WiseLord/ampcontrol/files/sch/ks0066.png

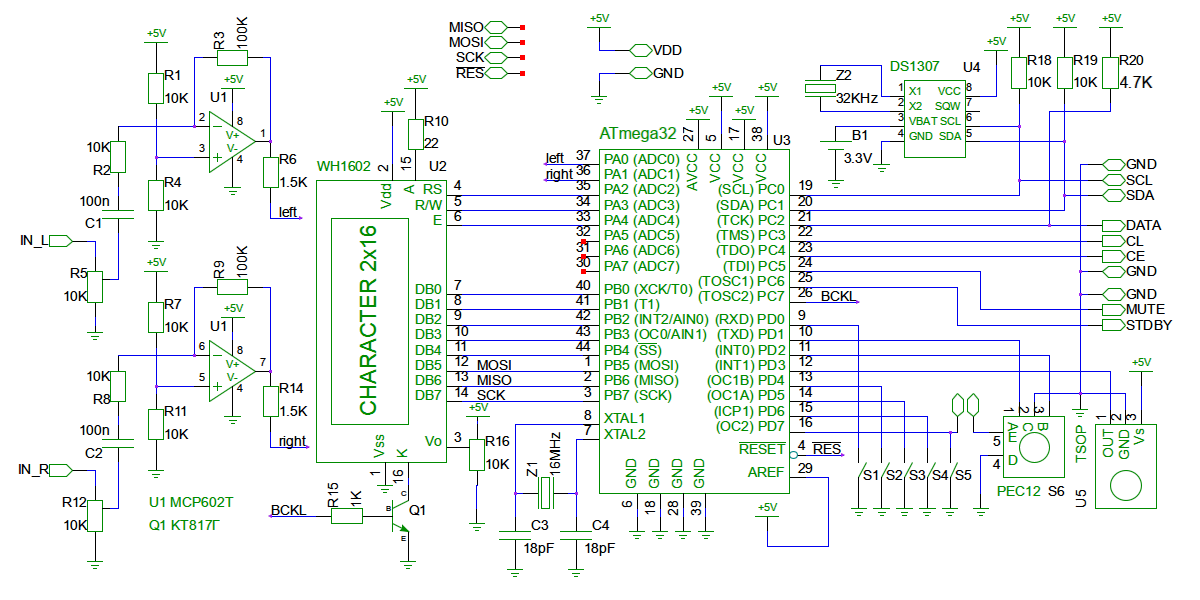
files/sch/ks0066.png
