WiseLord/ampcontrol/files/sch/ks0108a.png

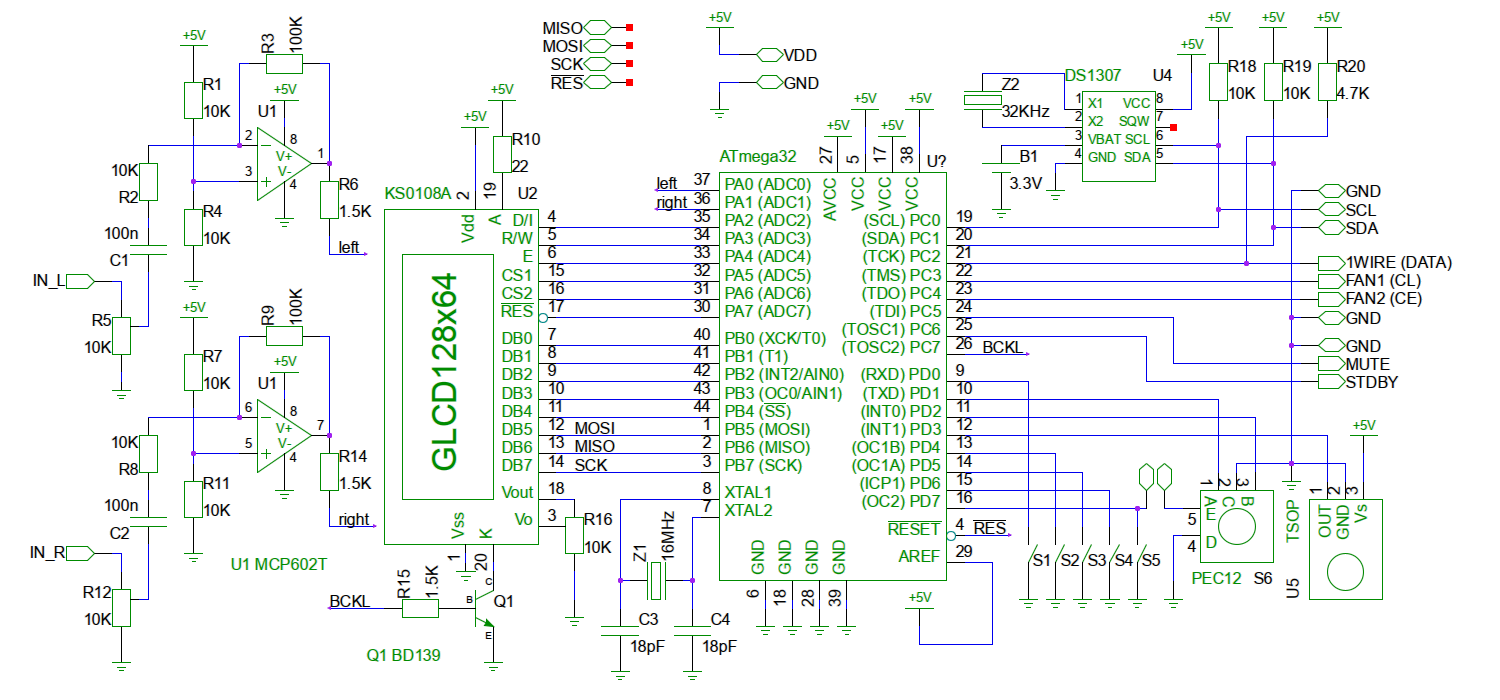
files/sch/ks0108a.png
