WiseLord/ampcontrol/files/sch/ls020.png

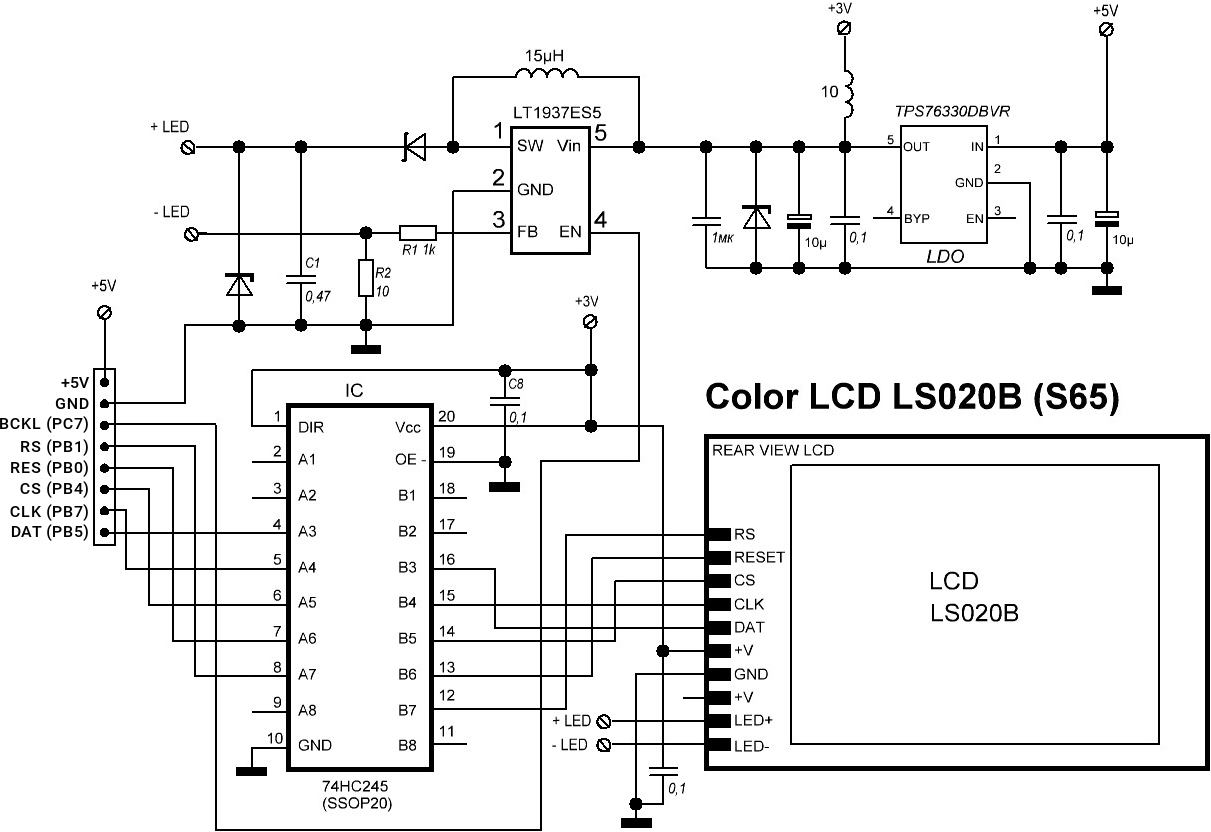
files/sch/ls020.png
