WiseLord/ampcontrol/files/sch/m328-ks0108a.png

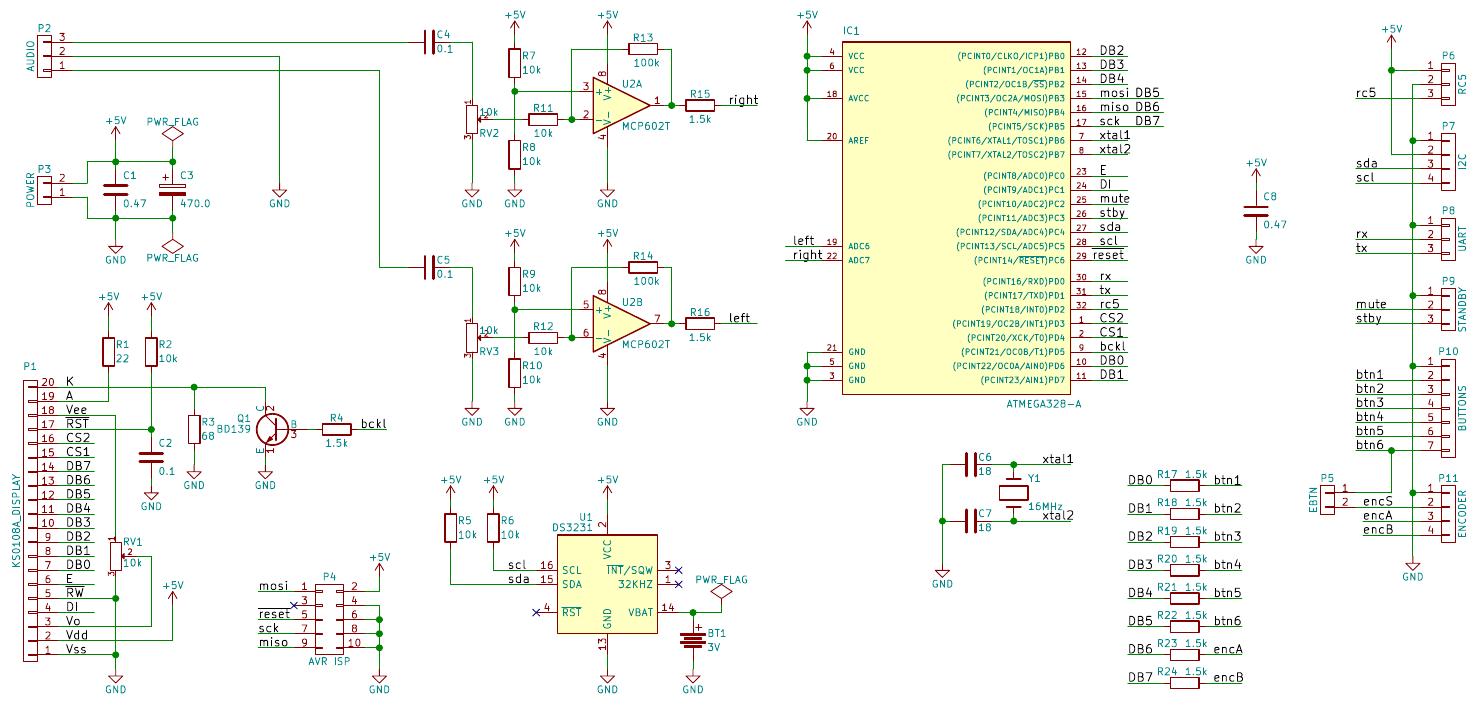
files/sch/m328-ks0108a.png
