WiseLord/ampcontrol/(threads)

Thread 2 (2016-12-08):

Настройки в виде меню

pirat777knj, 2016-12-08:
Хотелось бы видеть более расширенные настройки.
Предлагаю для настроек всего и вся использовать отдельную кнопку "меню",
и внутри менюшку. Структура вложена в файле.
[Структура меню.pdf](https://github.com/WiseLord/ampcontrol/files/640068/default.pdf)

Ну и естественно оставить кнопку быстрых настроек аудио.

pirat777knj, 2016-12-08:
Извиняюсь. Писал с телефона. Не знаю что с форматирование. Дома попробую поправить

WiseLord, 2016-12-08:
Непонятна структура такого меню, как оно должно выглядеть, и как им управлять.

pirat777knj, 2016-12-08:
Сделал в файле. Должно быть понятно.
Также есть еще одно пожелание.
При регулировке громкости сделайте, пожалуйста, отображение единицами в плюс.
А то регулировка сбивает с толку. Домочадцы уже весь мозг проели вопросом: почему так?
А вот в предусилителе, думаю, будет толково оставить регулировку в минус.

pirat777knj, 2016-12-08:
Спешу сообщить - оформил, чтобы было понятно.
Вы просто молодец. Хорошая у Вас родилась мысль и Вы её развиваете.

2016-12-08 14:06 GMT+03:00 WiseLord <notifications@github.com>:

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

WiseLord, 2016-12-08:
Такая структура меню и настроек звука (отдельный набор тембров и т.д. для каждого входа) полностью несовместима с текущим кодом. Возможно. в другом проекте что-то подобное и будет.

Показания при регулировках полностью соответстауют даташитам на аудиопроцессоры и здравому смыслу. Менять их на "попугаи" от нуля до N нет никакого смысла.

По поводу регулировки контраста хотелось бы узнать, как это физически должно происходить.

Ну и хотелось бы увидеть, как в подобном меню должно реализовываться управление кнопками.

pirat777knj, 2016-12-08:
Эм... То есть как физически должена происходить регулировка контраста? Он
же сделана. У меня через пять минут контраст падает. И обратно
восстанавливается только когда выключишь. Или начнешь яркость регулировать.
В остальных случаях он не возвращается обратно.
Неужели это где то косяк? 0_о

Навигация..... Нажатие на энкодер - вход, скажем 3я кнопка - назад,
вращение энкодера - пролистывание. Как на 3д принтерах сделано. Там один
энкодер. А меню огроменное!

А в каком другом проекте вы будете это реализовывать?

8 дек. 2016 г. 20:36 пользователь "WiseLord" <notifications@github.com>
написал:

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

WiseLord, 2016-12-08:
Контраст постоянен и задаётся только подстроечными резисторами. Если он меняется во время работы - ничего кроме плавающего напряжения питания на ум не приходит.

pirat777knj, 2016-12-08:
С этим буду разбираться. До мя доперло, что что-то не так.

8 дек. 2016 г. 20:54 пользователь "WiseLord" <notifications@github.com>
написал:

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

pirat777knj, 2016-12-12:
Добрый день. Вижу вас совсем не интересует предложенный мной функционал.
Несмотря на то, что промышленные ресиверы им обладают.
Как вы уже догадались - то я купил вашу плату в виде конструктора.
Не буду капать на мозги обратной связью с разработчиком и прочим. На этом
форуме все равно никогда не прислушиваются и почему-то считают всё бредом.
Сделаем проще. Вас устроит цена в 500 рублей за пару строк кода?

8 дек. 2016 г. 20:58 пользователь "Ратибор Конжин" <pirat777knj@gmail.com>
написал:

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

Arik333, 2016-12-13:
Прошу добавить поддержку синтезатора LC72131.

Closed 2020-04-08.

Thread 4 (2017-06-29):

Ошибка при компиляции, в чём причина подскажите

freecheng01, 2017-06-29:
C:\ampcontrol-m32-20170109\fft.c:38: ошибка: 'sinTable' is static but used in inline function 'sinTbl' which is not static [-Werror]
  ret = pgm_read_byte(&sinTable[phi & 0x1F]);
                       ^

WiseLord, 2017-06-29:
Причина указана в сообщении об ошибке. Берите или компилятор подревнее (<5.0) или исходники поновее, где это уже поправлено https://github.com/WiseLord/ampcontrol/commit/c34a5e0815c25a95a042597a09573819a85a126e

freecheng01, 2017-06-29:
Спасибо, немного уже разобрался , взял 5c041ba всё проходит. Ещё вопрос - для корпуса dip40 изменений в программе не требуется? Разводку печатки переделаю под себя.

WiseLord, 2017-06-29:
Нет, главное, чтобы функционально те же ножки (пусть и с другой нумерацией) были использованы на тех же местах. Кстати, на форуме радиокота, где-то на первых страницах ветки, плата под DIP40 корпус выкладывалась.

freecheng01, 2017-06-29:
Здорово, сейчас поищу. Ещё раз спасибо за проект, сам я пытался на 328 сделать но не осилил, знаний маловато и опыта, а Ваш проект зацепил, особенно в плане прорисовки экрана из ОЗУ. Буду его использовать как обучалку.

WiseLord, 2017-06-29:
Собственно, ветка кода под m328 в проекте тоже имеется.

Closed 2017-06-29.

Thread 5 (2019-10-24):

перестало компилиться

garik816, 2019-10-24:
перестало компилиться после вчерашнего обновления (Align with m8 code)

ampcontrol-m16# make -j4 MCU=atmega16 APROC_LIST=TDA7439 TUNER_LIST=NOTUNER DISPLAY=KS0066_16X2_8BIT
avr-gcc -Wall -Werror -lm -Os -mcall-prologues -fshort-enums -ffunction-sections -fdata-sections -ffreestanding -flto -mmcu=atmega16 -DF_CPU=16000000L -MMD -MP -MT build/main.o -MF build/./main.d -D_atmega16 -D_KS0066_16X2_8BIT -D_TDA7439 -D_NOTUNER -D_RDA5807_DF -c -o build/main.o main.c
avr-gcc -Wall -Werror -lm -Os -mcall-prologues -fshort-enums -ffunction-sections -fdata-sections -ffreestanding -flto -mmcu=atmega16 -DF_CPU=16000000L -MMD -MP -MT build/input.o -MF build/./input.d -D_atmega16 -D_KS0066_16X2_8BIT -D_TDA7439 -D_NOTUNER -D_RDA5807_DF -c -o build/input.o input.c
avr-gcc -Wall -Werror -lm -Os -mcall-prologues -fshort-enums -ffunction-sections -fdata-sections -ffreestanding -flto -mmcu=atmega16 -DF_CPU=16000000L -MMD -MP -MT build/actions.o -MF build/./actions.d -D_atmega16 -D_KS0066_16X2_8BIT -D_TDA7439 -D_NOTUNER -D_RDA5807_DF -c -o build/actions.o actions.c
avr-gcc -Wall -Werror -lm -Os -mcall-prologues -fshort-enums -ffunction-sections -fdata-sections -ffreestanding -flto -mmcu=atmega16 -DF_CPU=16000000L -MMD -MP -MT build/i2c.o -MF build/./i2c.d -D_atmega16 -D_KS0066_16X2_8BIT -D_TDA7439 -D_NOTUNER -D_RDA5807_DF -c -o build/i2c.o i2c.c
avr-gcc -Wall -Werror -lm -Os -mcall-prologues -fshort-enums -ffunction-sections -fdata-sections -ffreestanding -flto -mmcu=atmega16 -DF_CPU=16000000L -MMD -MP -MT build/rtc.o -MF build/./rtc.d -D_atmega16 -D_KS0066_16X2_8BIT -D_TDA7439 -D_NOTUNER -D_RDA5807_DF -c -o build/rtc.o rtc.c
avr-gcc -Wall -Werror -lm -Os -mcall-prologues -fshort-enums -ffunction-sections -fdata-sections -ffreestanding -flto -mmcu=atmega16 -DF_CPU=16000000L -MMD -MP -MT build/remote.o -MF build/./remote.d -D_atmega16 -D_KS0066_16X2_8BIT -D_TDA7439 -D_NOTUNER -D_RDA5807_DF -c -o build/remote.o remote.c
avr-gcc -Wall -Werror -lm -Os -mcall-prologues -fshort-enums -ffunction-sections -fdata-sections -ffreestanding -flto -mmcu=atmega16 -DF_CPU=16000000L -MMD -MP -MT build/fft.o -MF build/./fft.d -D_atmega16 -D_KS0066_16X2_8BIT -D_TDA7439 -D_NOTUNER -D_RDA5807_DF -c -o build/fft.o fft.c
avr-gcc -Wall -Werror -lm -Os -mcall-prologues -fshort-enums -ffunction-sections -fdata-sections -ffreestanding -flto -mmcu=atmega16 -DF_CPU=16000000L -MMD -MP -MT build/adc.o -MF build/./adc.d -D_atmega16 -D_KS0066_16X2_8BIT -D_TDA7439 -D_NOTUNER -D_RDA5807_DF -c -o build/adc.o adc.c
avr-gcc -Wall -Werror -lm -Os -mcall-prologues -fshort-enums -ffunction-sections -fdata-sections -ffreestanding -flto -mmcu=atmega16 -DF_CPU=16000000L -MMD -MP -MT build/ks0066.o -MF build/display/ks0066.d -D_atmega16 -D_KS0066_16X2_8BIT -D_TDA7439 -D_NOTUNER -D_RDA5807_DF -c -o build/display/ks0066.o display/ks0066.c
avr-gcc -Wall -Werror -lm -Os -mcall-prologues -fshort-enums -ffunction-sections -fdata-sections -ffreestanding -flto -mmcu=atmega16 -DF_CPU=16000000L -MMD -MP -MT build/display.o -MF build/./display.d -D_atmega16 -D_KS0066_16X2_8BIT -D_TDA7439 -D_NOTUNER -D_RDA5807_DF -c -o build/display.o display.c
avr-gcc -Wall -Werror -lm -Os -mcall-prologues -fshort-enums -ffunction-sections -fdata-sections -ffreestanding -flto -mmcu=atmega16 -DF_CPU=16000000L -MMD -MP -MT build/audio.o -MF build/audio/audio.d -D_atmega16 -D_KS0066_16X2_8BIT -D_TDA7439 -D_NOTUNER -D_RDA5807_DF -c -o build/audio/audio.o audio/audio.c
display.c:701:7: error: expected identifier or ‘(’ before ‘else’
     } else {
       ^
display.c:704:1: error: expected identifier or ‘(’ before ‘}’ token
 }
 ^
make: *** [Makefile:152: build/display.o] Ошибка 1
make: *** Ожидание завершения заданий…

Closed 2019-10-27.
