WiseLord/ampcontrol/(list of files, drawings)

Other design files:
files/pcbs-m32.lay6
files/sim-m32-proteus7-ls020.dsn
files/sim-m32-proteus7.dsn
files/sim-m328-proteus7.dsn
