WiseLord/ampcontrol/remote/defines.h

#ifndef DEFINES_H
#define DEFINES_H

#define ORGANIZATION_NAME           "WiseLord"
#define ORGANIZATION_DOMAIN         "github.io"
#define APPLICATION_NAME            "Ampcontrol"

#define SETTINGS_SERIAL             "SerialPort"
#define SETTINGS_SERIAL_PORTNAME    "SerialPort/PortName"
#define SETTINGS_SERIAL_BAUDRATE    "SerialPort/BaudRate"
#define SETTINGS_SERIAL_DATABITS    "SerialPort/DataBits"
#define SETTINGS_SERIAL_PARITY      "SerialPort/Parity"
#define SETTINGS_SERIAL_STOPBITS    "SerialPort/StopBits"
#define SETTINGS_SERIAL_FLOWCTRL    "SerialPort/FlowCtrl"

#define SETTINGS_BT                 "Bluetooth"
#define SETTINGS_BT_DEVICE          "Bluetooth/Device"

#define SETTINGS_APP                "Application"
#define SETTINGS_APP_AUTOCONNECT    "Application/Autoconnect"
#define SETTINGS_APP_AUTOCONNTIME   "Application/AutoconnectTimeout"
#define SETTINGS_APP_HIDEONSTART    "Application/HideOnStartup"

#endif // DEFINES_H
