WiseLord/ampcontrol/remote/main.cpp

#include "mainwindow.h"
#include "defines.h"

#include <QApplication>
#include <QTranslator>

int main(int argc, char *argv[])
{
    QCoreApplication::setOrganizationName(ORGANIZATION_NAME);
    QCoreApplication::setOrganizationDomain(ORGANIZATION_DOMAIN);
    QCoreApplication::setApplicationName(APPLICATION_NAME);

    QApplication a(argc, argv);

    QTranslator translator;
    translator.load(":/ts/ts/remote_" + QLocale::system().bcp47Name().remove(QRegExp("-.*")));
    a.installTranslator(&translator);

    MainWindow w;

    return a.exec();
}
