WiseLord/ampcontrol/src/display.c

#include "display.h"

#include <avr/pgmspace.h>
#include <avr/eeprom.h>

#ifdef _ALARM
#include "alarm.h"
#endif
#include "adc.h"
#include "eeprom.h"
#include "input.h"
#include "remote.h"
#include "rtc.h"
#include "tuner/tuner.h"
#ifdef _RDS
#include "tuner/rds.h"
#endif
#ifdef _TEMPCONTROL
#include "temp.h"
#endif

static int8_t brStby;                       // Brightness in standby mode
static int8_t brWork;                       // Brightness in working mode

static SpMode spMode;                       // Spectrum mode
static FallSpeed fallSpeed;                 // Spectrum fall speed

static uint8_t rcIndex = CMD_RC_STBY;

static uint8_t defDisplay;                  // Default display mode

char strbuf[STR_BUFSIZE + 1];               // String buffer
uint8_t *txtLabels[LABEL_END];              // Array with text label pointers

#if defined(_KS0066)
static LcdSymGroup userSybmols = LCD_END;   // Generated user symbols for ks0066
static LcdUserAddSym userAddSym = SYM_END;  // Additional user symbol
#endif

// Names of RC functions, MUST correspond to CmdID enum
const char STR_RC_STBY[]        PROGMEM = "Standby mode";
const char STR_RC_MUTE[]        PROGMEM = "Mute sound";
const char STR_RC_NEXT_SNDPAR[] PROGMEM = "Sound menu";
const char STR_RC_VOL_UP[]      PROGMEM = "Volume +";
const char STR_RC_VOL_DOWN[]    PROGMEM = "Volume -";
const char STR_RC_IN_0[]        PROGMEM = "Input 1";
const char STR_RC_IN_1[]        PROGMEM = "Input 2";
const char STR_RC_IN_2[]        PROGMEM = "Input 3";
const char STR_RC_IN_3[]        PROGMEM = "Input 4";
const char STR_RC_IN_4[]        PROGMEM = "Input 5";
const char STR_RC_IN_PREV[]     PROGMEM = "Prev input";
const char STR_RC_IN_NEXT[]     PROGMEM = "Next input";
const char STR_RC_LOUDNESS[]    PROGMEM = "Loudness";
const char STR_RC_SURROUND[]    PROGMEM = "Surround";
const char STR_RC_EFFECT_3D[]   PROGMEM = "3D effect";
const char STR_RC_TONE_BYPASS[] PROGMEM = "Tone bypass";

const char STR_RC_FM_RDS[]      PROGMEM = "RDS enable";
const char STR_RC_FM_INC[]      PROGMEM = "Channel +";
const char STR_RC_FM_DEC[]      PROGMEM = "Channel -";
const char STR_RC_FM_MODE[]     PROGMEM = "FM tune";
const char STR_RC_FM_MONO[]     PROGMEM = "FM mono";
const char STR_RC_FM_STORE[]    PROGMEM = "Store freq";
const char STR_RC_FM_0[]        PROGMEM = "Button 0";
const char STR_RC_FM_1[]        PROGMEM = "Button 1";
const char STR_RC_FM_2[]        PROGMEM = "Button 2";
const char STR_RC_FM_3[]        PROGMEM = "Button 3";
const char STR_RC_FM_4[]        PROGMEM = "Button 4";
const char STR_RC_FM_5[]        PROGMEM = "Button 5";
const char STR_RC_FM_6[]        PROGMEM = "Button 6";
const char STR_RC_FM_7[]        PROGMEM = "Button 7";
const char STR_RC_FM_8[]        PROGMEM = "Button 8";
const char STR_RC_FM_9[]        PROGMEM = "Button 9";

const char STR_RC_TIME[]        PROGMEM = "Time";
const char STR_RC_ALARM[]       PROGMEM = "Alarm";
const char STR_RC_TIMER[]       PROGMEM = "Timer";
const char STR_RC_BRIGHTNESS[]  PROGMEM = "Brightness";
const char STR_RC_DEF_DISPLAY[] PROGMEM = "Display mode";
const char STR_RC_NEXT_SPMODE[] PROGMEM = "Spectrum mode";
const char STR_RC_FALLSPEED[]   PROGMEM = "Fall speed";

// Array of pointers to RC functions names, MUST correspond to CmdID enum
PGM_P const rcLabels[] PROGMEM = {
    STR_RC_STBY,
    STR_RC_MUTE,
    STR_RC_NEXT_SNDPAR,
    STR_RC_VOL_UP,
    STR_RC_VOL_DOWN,
    STR_RC_IN_0,
    STR_RC_IN_1,
    STR_RC_IN_2,
    STR_RC_IN_3,
    STR_RC_IN_4,
    STR_RC_IN_PREV,
    STR_RC_IN_NEXT,
    STR_RC_LOUDNESS,
    STR_RC_SURROUND,
    STR_RC_EFFECT_3D,
    STR_RC_TONE_BYPASS,

    STR_RC_FM_RDS,
    STR_RC_FM_INC,
    STR_RC_FM_DEC,
    STR_RC_FM_MODE,
    STR_RC_FM_MONO,
    STR_RC_FM_STORE,
    STR_RC_FM_0,
    STR_RC_FM_1,
    STR_RC_FM_2,
    STR_RC_FM_3,
    STR_RC_FM_4,
    STR_RC_FM_5,
    STR_RC_FM_6,
    STR_RC_FM_7,
    STR_RC_FM_8,
    STR_RC_FM_9,

    STR_RC_TIME,
    STR_RC_ALARM,
    STR_RC_TIMER,
    STR_RC_BRIGHTNESS,
    STR_RC_DEF_DISPLAY,
    STR_RC_NEXT_SPMODE,
    STR_RC_FALLSPEED,
};

// Other strings stored in PROGMEM
const char STR_IN_STATUS[]      PROGMEM = "BUTTONS & ENCODER";
const char STR_REMOTE[]         PROGMEM = "Remote";
const char STR_BUTTONS[]        PROGMEM = "Status";
const char STR_LEARN[]          PROGMEM = "REMOTE CONTROL";
const char STR_FUNCTION[]       PROGMEM = "Function";
const char STR_ADDRESS[]        PROGMEM = "Address";
const char STR_COMMAND[]        PROGMEM = "Command";
const char STR_RC_RC5[]         PROGMEM = "RC5";
const char STR_RC_NEC[]         PROGMEM = "NEC";
const char STR_RC_RC6[]         PROGMEM = "RC6";
const char STR_RC_SAM[]         PROGMEM = "SAM";
const char STR_RC_NONE[]        PROGMEM = "---";

const char STR_THRESHOLD[]      PROGMEM = "Threshold";
const char STR_DEGREE[]         PROGMEM = "\x7F\xEF""C";
#if defined(_LS020)
const char STR_SENSOR1[]        PROGMEM = "S 1: ";
const char STR_SENSOR2[]        PROGMEM = "S 2: ";
#else
const char STR_SENSOR1[]        PROGMEM = "Sensor 1: ";
const char STR_SENSOR2[]        PROGMEM = "Sensor 2: ";
#endif
const char STR_SPDIVSP[]        PROGMEM = "\x7F/\x7F";
const char STR_SPARRSP[]        PROGMEM = " => ";
const char STR_SPDOTSP[]        PROGMEM = "\x7F.\x7F";
const char STR_SPCOLSP[]        PROGMEM = "\x7F:\x7F";
const char STR_SP[]             PROGMEM = "\x7F";
const char STR_SPACE2[]         PROGMEM = "  ";
const char STR_SPACE3[]         PROGMEM = "   ";
const char STR_MINUS1[]         PROGMEM = "-";
const char STR_MINUS2[]         PROGMEM = "--";
const char STR_SPMINUS2[]       PROGMEM = " --";

const char STR_FM[]             PROGMEM = "FM ";
const char STR_STEREO[]         PROGMEM = "ST";
const char STR_MONO[]           PROGMEM = "MO";
const char STR_TUNE[]           PROGMEM = "<<>>";
const char STR_RDS[]            PROGMEM = "RDS";

const char STR_YEAR20[]         PROGMEM = "20";

const char STR_PREFIX_BIN[]     PROGMEM = "0b\x7F";
const char STR_PREFIX_HEX[]     PROGMEM = "0x\x7F";

#if defined(_KS0066)
static void lcdGenLevels()
{
    if (userSybmols != LCD_LEVELS) {        // Generate 7 level symbols
        userSybmols = LCD_LEVELS;

        uint8_t i, j;
        ks0066SelectSymbol(0);
        for (i = 0; i < 7; i++)
            for (j = 0; j < 8; j++)
                if (i + j >= 7)
                    ks0066WriteData(0xFF);
                else
                    ks0066WriteData(0x00);
    }
}

static void lcdGenBar(LcdUserAddSym sym)
{
    static const uint8_t bar[] PROGMEM = {
        0b00000,
        0b10000,
        0b10100,
        0b10101,
        0b00101,
        0b00001,
    };
    static const uint8_t speakerIcon[] PROGMEM = {
        0b00001,
        0b00011,
        0b11101,
        0b10101,
        0b11101,
        0b00011,
        0b00001,
        0b00000,
    };
    static const uint8_t loudnessIcon[] PROGMEM = {
        0b00000,
        0b10000,
        0b10001,
        0b10101,
        0b10101,
        0b10101,
        0b10101,
        0b00000,
    };
    static const uint8_t surroundIcon[] PROGMEM = {
        0b01010,
        0b10001,
        0b10101,
        0b10101,
        0b10101,
        0b10001,
        0b01010,
        0b00000,
    };
    static const uint8_t effect3dIcon[] PROGMEM = {
        0b01110,
        0b10001,
        0b00000,
        0b01110,
        0b00000,
        0b10001,
        0b01110,
        0b00000,
    };
    static const uint8_t toneBypassIcon[] PROGMEM = {
        0b01000,
        0b10101,
        0b00010,
        0b00000,
        0b11111,
        0b00000,
        0b11111,
        0b00000,
    };
    static const uint8_t stereoIcon[] PROGMEM = {
        0b00000,
        0b11011,
        0b10101,
        0b10101,
        0b10101,
        0b11011,
        0b00000,
        0b00000,
    };
    static const uint8_t monoIcon[] PROGMEM = {
        0b00000,
        0b00111,
        0b01001,
        0b01001,
        0b01001,
        0b00111,
        0b00000,
        0b00000,
    };
    static const uint8_t crossIcon[] PROGMEM = {
        0b00000,
        0b10001,
        0b01010,
        0b00100,
        0b01010,
        0b10001,
        0b00000,
        0b00000,
    };
    static const uint8_t degreeIcon[] PROGMEM = {
        0b00110,
        0b01001,
        0b01001,
        0b00110,
        0b00000,
        0b00000,
        0b00000,
        0b00000,
    };

    uint8_t i;

    if (userSybmols != LCD_BAR || userAddSym != sym) {
        // Generate main 6 bar symbols
        userSybmols = LCD_BAR;
        ks0066SelectSymbol(0);
        for (i = 0; i < 48; i++) {
            if ((i & 0x07) == 0x03) {
                ks0066WriteData(0x15);
            } else if ((i & 0x07) == 0x07) {
                ks0066WriteData(0x00);
            } else {
                ks0066WriteData(pgm_read_byte(&bar[i >> 3]));
            }
        }
        // Generate two additional symbols
        userAddSym = sym;
        switch (sym) {
        case SYM_MUTE_CROSS:
            for (i = 0; i < 8; i++)
                ks0066WriteData(pgm_read_byte(&speakerIcon[i]));
            for (i = 0; i < 8; i++)
                ks0066WriteData(pgm_read_byte(&crossIcon[i]));
            break;
        case SYM_LOUDNESS_CROSS:
            for (i = 0; i < 8; i++)
                ks0066WriteData(pgm_read_byte(&loudnessIcon[i]));
            for (i = 0; i < 8; i++)
                ks0066WriteData(pgm_read_byte(&crossIcon[i]));
            break;
        case SYM_SURROUND_CROSS:
            for (i = 0; i < 8; i++)
                ks0066WriteData(pgm_read_byte(&surroundIcon[i]));
            for (i = 0; i < 8; i++)
                ks0066WriteData(pgm_read_byte(&crossIcon[i]));
            break;
        case SYM_EFFECT_3D_CROSS:
            for (i = 0; i < 8; i++)
                ks0066WriteData(pgm_read_byte(&effect3dIcon[i]));
            for (i = 0; i < 8; i++)
                ks0066WriteData(pgm_read_byte(&crossIcon[i]));
            break;
        case SYM_TONE_BYPASS_CROSS:
            for (i = 0; i < 8; i++)
                ks0066WriteData(pgm_read_byte(&toneBypassIcon[i]));
            for (i = 0; i < 8; i++)
                ks0066WriteData(pgm_read_byte(&crossIcon[i]));
            break;
        case SYM_STEREO_MONO:
            for (i = 0; i < 8; i++)
                ks0066WriteData(pgm_read_byte(&stereoIcon[i]));
            for (i = 0; i < 8; i++)
                ks0066WriteData(pgm_read_byte(&monoIcon[i]));
            break;
        default:
            for (i = 0; i < 8; i++)
                ks0066WriteData(pgm_read_byte(&stereoIcon[i]));
            for (i = 0; i < 8; i++)
                ks0066WriteData(pgm_read_byte(&degreeIcon[i]));
            break;
        }
    }
}

static void lcdGenAlarm()
{
    static const uint8_t alarmSym[] PROGMEM = {
        // Filled rectangle
        0b11111,
        0b00000,
        0b00000,
        0b00000,
        0b00000,
        0b00000,
        0b11111,
        0b00000,
        // Empty rectangle
        0b11111,
        0b00000,
        0b11111,
        0b11111,
        0b11111,
        0b00000,
        0b11111,
        0b00000,
        // Space between rectangles
        0b10001,
        0b10001,
        0b10001,
        0b10001,
        0b10001,
        0b10001,
        0b10001,
        0b00000,
        // Visible left bracket
        0b11001,
        0b10001,
        0b10001,
        0b10001,
        0b10001,
        0b10001,
        0b11001,
        0b00000,
        // Invisible left bracket
        0b00001,
        0b00001,
        0b00001,
        0b00001,
        0b00001,
        0b00001,
        0b00001,
        0b00000,
        // Visible right bracket
        0b10011,
        0b10001,
        0b10001,
        0b10001,
        0b10001,
        0b10001,
        0b10011,
        0b00000,
        // Invisible right bracket
        0b10000,
        0b10000,
        0b10000,
        0b10000,
        0b10000,
        0b10000,
        0b10000,
        0b00000,

    };
    if (userSybmols != LCD_ALARM) { // Generate alarm symbols
        userSybmols = LCD_ALARM;

        uint8_t i;
        ks0066SelectSymbol(0);
        for (i = 0; i < sizeof(alarmSym); i++)
            ks0066WriteData(pgm_read_byte(&alarmSym[i]));
    }
}
#endif


static void showBar(int16_t min, int16_t max, int16_t value)
{
#if defined(_KS0066)
    uint8_t i;

    lcdGenBar(userAddSym);

    ks0066SetXY(0, 1);

    if (min + max) {
        value = (int16_t)48 * (value - min) / (max - min);
        for (i = 0; i < 16; i++) {
            if (value / 3 > i) {
                ks0066WriteData(0x03);
            } else {
                if (value / 3 < i) {
                    ks0066WriteData(0x00);
                } else {
                    ks0066WriteData(value % 3);
                }
            }
        }
    } else {
        value = (int16_t)23 * value / max;
        if (value >= 0) {
            value++;
            for (i = 0; i < 7; i++) {
                ks0066WriteData(0x00);
            }
            ks0066WriteData(0x05);
            for (i = 0; i < 8; i++) {
                if (value / 3 > i) {
                    ks0066WriteData(0x03);
                } else {
                    if (value / 3 < i) {
                        ks0066WriteData(0x00);
                    } else {
                        ks0066WriteData(value % 3);
                    }
                }
            }
        } else {
            value += 23;
            for (i = 0; i < 8; i++) {
                if (value / 3 > i) {
                    ks0066WriteData(0x00);
                } else {
                    if (value / 3 < i) {
                        ks0066WriteData(0x03);
                    } else {
                        ks0066WriteData(value % 3 + 3);
                    }
                }
            }
            ks0066WriteData(0x01);
            for (i = 0; i < 7; i++) {
                ks0066WriteData(0x00);
            }
        }
    }
#elif defined(_LS020)
    uint8_t i;
    uint8_t color;

    if (min + max) {
        value = (int16_t)161 * (value - min) / (max - min);
    } else {
        value = (int16_t)80 * value / max;
    }

    for (i = 0; i < 161; i += 4) {
        if (((min + max) && (value <= i)) || (!(min + max) &&
                                              (((value > 0) && ((i < 80) || (value + 80 < i))) ||
                                               ((value <= 0) && ((i > 80) || (value + 80 > i)))))) {
            color = COLOR_BLACK;
        } else {
            color = COLOR_CYAN;
        }

        ls020DrawRect(i + 2, 58, i + 3, 67, color);
        ls020DrawRect(i + 2, 68, i + 3, 68, COLOR_CYAN);
        ls020DrawRect(i + 2, 69, i + 3, 78, color);
    }
#else
    uint8_t i, j;
    uint8_t color;

    if (min + max) {
        value = (uint16_t)91 * (value - min) / (max - min);
    } else {
        value = (int16_t)45 * value / max;
    }

    for (i = 0; i < 91; i++) {
        if (((min + max) && (value <= i)) || (!(min + max) &&
                                              (((value > 0) && ((i < 45) || (value + 45 < i))) ||
                                               ((value <= 0) && ((i > 45) || (value + 45 > i)))))) {
            color = 0x00;
        } else {
            color = 0x01;
        }
        if (!(i & 0x01)) {
            for (j = 27; j < 38; j++) {
                if (j == 32) {
                    gdDrawPixel(i, j, 1);
                } else {
                    gdDrawPixel(i, j, color);
                }
            }
        }
    }
#endif
}


static void writeStringEeprom(const uint8_t *string)
{
    eeprom_read_block(strbuf, string, STR_BUFSIZE);

    writeString(strbuf);
}

static void writeStringPgm(const char *string)
{
    strcpy_P(strbuf, string);
    writeString(strbuf);
}

static void writeNum(int16_t number, uint8_t width, uint8_t lead, uint8_t radix)
{
    uint8_t numdiv;
    uint8_t sign = lead;
    int8_t i;

    if (number < 0) {
        sign = '-';
        number = -number;
    }

    for (i = 0; i < width; i++)
        strbuf[i] = lead;
    strbuf[width] = '\0';
    i = width - 1;

    while (number > 0 || i == width - 1) {
        numdiv = number % radix;
        strbuf[i] = numdiv + 0x30;
        if (numdiv >= 10)
            strbuf[i] += 7;
        i--;
        number /= radix;
    }

    if (i >= 0)
        strbuf[i] = sign;

    writeString(strbuf);
}


static void showParValue(int8_t value)
{
#if defined(_KS0066)
    ks0066SetXY(11, 0);
    writeNum(value, 3, ' ', 10);
#elif defined(_LS020)
    ls020LoadFont(font_digits_32, COLOR_CYAN, 1);
    ls020SetXY(126, 88);
    writeNum(value, 3, ' ', 10);
#else
    gdLoadFont(font_ks0066_ru_24, 1, FONT_DIR_0);
    gdSetXY(94, 30);
    writeNum(value, 3, ' ', 10);
#endif
}

static void showParLabel(uint8_t label)
{
#if defined(_KS0066)
    ks0066SetXY (0, 0);
    writeStringEeprom(txtLabels[label]);
#elif defined(_LS020)
    ls020LoadFont(font_ks0066_ru_24, COLOR_CYAN, 1);
    ls020SetXY(2, 4);
    writeStringEeprom(txtLabels[label]);
#else
    gdLoadFont(font_ks0066_ru_24, 1, FONT_DIR_0);
    gdSetXY(0, 0);
    writeStringEeprom(txtLabels[label]);
#endif
}

#if !defined(_KS0066)
static void showParIcon(uint8_t icon)
{
    uint8_t ic = icon;

    if (ic >= MODE_SND_GAIN0 && ic < MODE_SND_END)
        ic = eeprom_read_byte((uint8_t *)(EEPROM_INPUT_ICONS + (ic - MODE_SND_GAIN0)));
    if (ic < ICON24_END)
        icon = ic;

#if defined(_LS020)
    ls020SetXY(148, 4);
    ls020WriteIcon24(icon);
#else
    gdSetXY(104, 2);
    gdWriteIcon24(icon);
#endif
}
#endif

#if defined(_KS0066)
#elif defined(_LS020)
static void drawSpCol(uint8_t xbase, uint8_t w, uint8_t btm, uint8_t val, uint8_t max)
{
    uint8_t i;

    val = (val < max ? btm - val : btm - max);

    for (i = 0; i < w; i++) {
        ls020DrawVertLine(xbase + i, btm, val, COLOR_YELLOW);
        ls020DrawVertLine(xbase + i, val > (btm - max) ? val - 1 : val, btm - max, COLOR_BLACK);
    }
}

static void drawBarSpectrum()
{
    uint8_t x, xbase;
    uint8_t ybase;

    for (x = 0; x < 31; x++) {
        xbase = x * 4 + 2;

        ybase = (buf[x] + buf[x + 32]) / 2;
        drawSpCol(xbase, 2, 129, ybase, 31);
        ls020DrawVertLine(xbase + 2, 129, 129 - 31, 0); // Clear space between bars
    }
}
#else
static void drawSpCol(uint8_t xbase, uint8_t w, uint8_t btm, uint8_t val, uint8_t max)
{
    uint8_t i;

    val = (val < max ? btm - val : btm - max);

    for (i = 0; i < w; i++) {
        gdDrawVertLine(xbase + i, btm, val, 1);
        gdDrawVertLine(xbase + i, val > (btm - max) ? val - 1 : val, btm - max, 0);
    }
}

static void drawBarSpectrum()
{
    uint8_t x, xbase;
    uint8_t ybase;

    for (x = 0; x < GD_SIZE_X / 4 - 1; x++) {
        xbase = x * 3;

        ybase = (buf[x] + buf[x + 32]) * 3 / 8;
        drawSpCol(xbase, 2, 63, ybase, 23);
        gdDrawVertLine(xbase + 2, 63, 63 - 23, 0); // Clear space between bars
    }
}
#endif


static void drawMiniSpectrum()
{
#if defined(_KS0066)
    uint16_t data;
    uint8_t i;

    lcdGenBar (userAddSym);
    data = 0;
    for (i = 0; i < FFT_SIZE / 2; i++) {
        data += buf[i];
        data += buf[FFT_SIZE / 2 + i];
    }
    data >>= 5;

    ks0066SetXY(0, 1);
    for (i = 0; i < KS0066_SCREEN_WIDTH; i++) {
        if (data / 3 > i) {
            ks0066WriteData(0x03);
        } else {
            if (data / 3 < i) {
                ks0066WriteData(0x00);
            } else {
                ks0066WriteData(data % 3);
            }
        }
    }
#elif defined(_LS020)
#else
    uint8_t x, xbase;
    uint8_t ybase;

    for (x = 0; x < GD_SIZE_X / 4 - 1; x++) {
        xbase = x * 3;
        ybase = (buf[x] * 5 / 2 + buf[x + 32] * 5 / 2) / 4;
        drawSpCol(xbase, 2, 63, ybase, 39);
    }
#endif
}

#if defined(_KS0066)
static void drawTm(uint8_t tm)
{
    if (rtc.etm != tm || (getSecTimer() % 512) < 200) {
        writeNum(*((int8_t *)&rtc + tm), 2, '0', 10);
    } else {
        writeString("  ");
    }
#elif defined(_LS020)
static void drawTm(uint8_t tm, const uint8_t *font, uint8_t mult) {
    ls020LoadFont(font, rtc.etm == tm ? COLOR_YELLOW : COLOR_CYAN, mult);
    writeNum(*((int8_t *)&rtc + tm), 2, '0', 10);
    ls020LoadFont(font, COLOR_CYAN, mult);
#else
static void drawTm(uint8_t tm, const uint8_t *font)
{
    gdLoadFont(font, rtc.etm == tm ? 0 : 1, FONT_DIR_0);
    writeNum(*((int8_t *)&rtc + tm), 2, '0', 10);
    gdLoadFont(font, 1, FONT_DIR_0);
#endif
}

#ifdef _ALARM
#if defined(_KS0066)
static void drawAm(uint8_t am)
{
    if (alarm0.eam != am || (getSecTimer() % 512) < 200) {
        writeNum(*((int8_t *)&alarm0 + am), 2, '0', 10);
    } else {
        writeString("  ");
    }
#elif defined(_LS020)
static void drawAm(uint8_t am, const uint8_t *font, uint8_t mult) {
    ls020LoadFont(font, alarm0.eam == am ? COLOR_YELLOW : COLOR_CYAN, mult);
    writeNum(*((int8_t *)&alarm0 + am), 2, '0', 10);
    ls020LoadFont(font, COLOR_CYAN, mult);
#else
static void drawAm(uint8_t am, const uint8_t *font)
{
    gdLoadFont(font, alarm0.eam == am ? 0 : 1, FONT_DIR_0);
    writeNum(*((int8_t *)&alarm0 + am), 2, '0', 10);
    gdLoadFont(font, 1, FONT_DIR_0);
#endif
}
#endif

void displayInit(void)
{
    uint8_t i;
    uint8_t *addr;

    addr = (uint8_t *)EEPROM_LABELS_ADDR;
    i = 0;

    while (i < LABEL_END && addr < (uint8_t *)EEPROM_SIZE) {
        if (eeprom_read_byte(addr) != '\0') {
            txtLabels[i] = addr;
            addr++;
            i++;
            while (eeprom_read_byte(addr) != '\0' &&
                   addr < (uint8_t *)EEPROM_SIZE) {
                addr++;
            }
        } else {
            addr++;
        }
    }

#if defined(_KS0066)
    ks0066Init();
    lcdGenLevels();
#elif defined(_LS020)
    ls020Init();
#else
    gdInit();
#endif

    brStby = eeprom_read_byte((uint8_t *)EEPROM_BR_STBY);
    brWork = eeprom_read_byte((uint8_t *)EEPROM_BR_WORK);
    spMode  = eeprom_read_byte((uint8_t *)EEPROM_SP_MODE);
    defDisplay = eeprom_read_byte((uint8_t *)EEPROM_DISPLAY);
    fallSpeed = eeprom_read_byte((uint8_t *)EEPROM_FALL_SPEED);
    if (fallSpeed > FALL_SPEED_FAST)
        fallSpeed = FALL_SPEED_FAST;
}

void displayPowerOff(void)
{
    eeprom_update_byte((uint8_t *)EEPROM_BR_WORK, brWork);
    eeprom_update_byte((uint8_t *)EEPROM_SP_MODE, spMode);
    eeprom_update_byte((uint8_t *)EEPROM_DISPLAY, defDisplay);
    eeprom_update_byte((uint8_t *)EEPROM_FALL_SPEED, fallSpeed);
}

void displayUpdate(void)
{

#if defined(_SSD1306)
    ssd1306UpdateFb();
#endif
}


void setDefDisplay(uint8_t value)
{
    defDisplay = value;
}

uint8_t getDefDisplay()
{
    return defDisplay;
}


void nextRcCmd(void)
{
    IRData irBuf = getIrData();

    eeprom_update_byte((uint8_t *)EEPROM_RC_TYPE, irBuf.type);
    eeprom_update_byte((uint8_t *)EEPROM_RC_ADDR, irBuf.address);
    eeprom_update_byte((uint8_t *)EEPROM_RC_CMD + rcIndex, irBuf.command);

    // Re-read new codes array from EEPROM
    rcCodesInit();

    if (++rcIndex >= CMD_RC_END)
        rcIndex = CMD_RC_STBY;

    switchRcCmd(rcIndex);
}

void switchRcCmd(uint8_t index)
{
    rcIndex = index;
    setIrData(eeprom_read_byte((uint8_t *)EEPROM_RC_TYPE),
              eeprom_read_byte((uint8_t *)EEPROM_RC_ADDR),
              eeprom_read_byte((uint8_t *)EEPROM_RC_CMD + rcIndex));
}


void switchSpMode()
{
    if (++spMode >= SP_MODE_END)
        spMode = SP_MODE_METER;
}

SpMode getSpMode(void)
{
    return spMode;
}

void switchFallSpeed(void)
{
    if (++fallSpeed > FALL_SPEED_END)
        fallSpeed = FALL_SPEED_LOW;
}


void getSpectrum(void)
{
    getSpData(fallSpeed);
}


void changeBrWork(int8_t diff)
{
    brWork += diff;
    if (brWork > MAX_BRIGHTNESS)
        brWork = MAX_BRIGHTNESS;
    if (brWork < MIN_BRIGHTNESS)
        brWork = MIN_BRIGHTNESS;
    setWorkBrightness();
}

void setWorkBrightness(void)
{
#if defined(_KS0066)
    ks0066SetBrightness(brWork);
#if defined(KS0066_WIRE_PCF8574)
    pcf8574SetBacklight(brWork);
#endif
#elif defined(_LS020)
    ls020SetBrightness(brWork);
#else
    gdSetBrightness(brWork);
#endif
}

void setStbyBrightness(void)
{
#if defined(_KS0066)
    ks0066SetBrightness(brStby);
#if defined(KS0066_WIRE_PCF8574)
    pcf8574SetBacklight(KS0066_BCKL_OFF);
#endif
#elif defined(_LS020)
    ls020SetBrightness(brStby);
#else
    gdSetBrightness(brStby);
#endif
}


#ifdef _ALARM
void showAlarm(void)
{
    uint8_t i;

#if defined(_KS0066)
    // Draw alarm value
    ks0066SetXY(0, 0);
    drawAm(ALARM_HOUR);
    ks0066WriteData(':');
    drawAm(ALARM_MIN);

    // Check that input number less than CHAN_CNT
    i = alarm0.input;
    if (i >= aproc.inCnt)
        i = 0;

    // Draw selected input
    ks0066SetXY(6, 0);
    if (alarm0.eam != ALARM_INPUT || (getSecTimer() % 512) < 200)
        writeStringEeprom(txtLabels[MODE_SND_GAIN0 + i]);
    // Clear string tail
    ks0066WriteTail (' ', 15);

    // Draw weekdays
    lcdGenAlarm ();
    ks0066SetXY(0, 1);
    if (alarm0.eam != ALARM_WDAY || (getSecTimer() % 512) < 200) {
        ks0066WriteData (0x04);
    } else {
        ks0066WriteData (0x03);
    }
    for (i = 0; i < 7; i++) {
        if (alarm0.wday & (0x40 >> i)) {
            ks0066WriteData (0x01);
        } else {
            ks0066WriteData (0x00);
        }
        if (i != 6)
            ks0066WriteData (0x02);
    }
    if (alarm0.eam != ALARM_WDAY || (getSecTimer() % 512) < 200) {
        ks0066WriteData (0x06);
    } else {
        ks0066WriteData (0x05);
    }
#elif defined(_LS020)
    uint8_t *label;

    ls020SetXY(20, 4);

    drawAm(ALARM_HOUR, font_ks0066_ru_24, 2);
    writeStringPgm(STR_SPCOLSP);
    drawAm(ALARM_MIN, font_ks0066_ru_24, 2);

    // Draw input icon selection rectangle
    if (alarm0.eam == ALARM_INPUT) {
        ls020DrawFrame(96 + 48, 0, 127 + 48, 31, COLOR_YELLOW);
        ls020DrawFrame(97 + 48, 1, 126 + 48, 30, COLOR_YELLOW);
    } else {
        ls020DrawFrame(96 + 48, 0, 127 + 48, 31, COLOR_BLACK);
        ls020DrawFrame(97 + 48, 1, 126 + 48, 30, COLOR_BLACK);
    }

    // Check that input number less than CHAN_CNT
    i = alarm0.input;
    if (i >= aproc.inCnt)
        i = 0;
    showParIcon(MODE_SND_GAIN0 + i);

    // Draw weekdays selection rectangle
    if (alarm0.eam == ALARM_WDAY) {
        ls020DrawFrame(0, 130, 175, 93, COLOR_YELLOW);
        ls020DrawFrame(1, 131, 174, 92, COLOR_YELLOW);
    } else {
        ls020DrawFrame(0, 130, 175, 93, COLOR_BLACK);
        ls020DrawFrame(1, 131, 174, 92, COLOR_BLACK);
    }

    // Draw weekdays
    ls020LoadFont(font_ks0066_ru_08, COLOR_CYAN, 1);
    label = txtLabels[LABEL_WEEKDAYS];
    for (i = 0; i < 7; i++) {
        ls020SetXY(5 + 25 * i, 38 + 63);
        ls020WriteChar(eeprom_read_byte(&label[i * 2]));
        ls020WriteChar(0x7F);
        ls020WriteChar(eeprom_read_byte(&label[i * 2 + 1]));

        ls020DrawFrame(3 + 25 * i, 47 + 63, 21 + 25 * i, 60 + 68, COLOR_CYAN);
        ls020DrawRect(6 + 25 * i, 50 + 63, 18 + 25 * i, 57 + 68,
                      alarm0.wday & (0x40 >> i) ? COLOR_CYAN : COLOR_BCKG);
    }
#else
    uint8_t *label;

    gdSetXY(4, 0);

    drawAm(ALARM_HOUR, font_digits_32);
    writeStringPgm(STR_SPCOLSP);
    drawAm(ALARM_MIN, font_digits_32);

    // Draw input icon selection
    if (alarm0.eam == ALARM_INPUT) {
        gdDrawFilledRect(99, 2, 3, 26, 1);
        gdDrawFilledRect(99, 28, 29, 3, 1);
    } else {
        gdDrawFilledRect(99, 2, 3, 26, 0);
        gdDrawFilledRect(99, 28, 29, 3, 0);
    }

    // Check that input number less than CHAN_CNT
    i = alarm0.input;
    if (i >= aproc.inCnt)
        i = 0;
    showParIcon(MODE_SND_GAIN0 + i);

    // Draw weekdays selection rectangle
    if (alarm0.eam == ALARM_WDAY) {
        gdDrawRect(0, 34, 128, 30, 1);
        gdDrawRect(1, 35, 126, 28, 1);
    } else {
        gdDrawRect(0, 34, 128, 30, 0);
        gdDrawRect(1, 35, 126, 28, 0);
    }

    // Draw weekdays
    gdLoadFont(font_ks0066_ru_08, 1, FONT_DIR_0);
    label = txtLabels[LABEL_WEEKDAYS];
    for (i = 0; i < 7; i++) {
        gdSetXY(5 + 18 * i, 38);
        gdWriteChar(eeprom_read_byte(&label[i * 2]));
        gdWriteChar(0x7F);
        gdWriteChar(eeprom_read_byte(&label[i * 2 + 1]));

        gdDrawRect(3 + 18 * i, 47, 14, 14, 1);
        if (alarm0.wday & (0x40 >> i))
            gdDrawFilledRect(5 + 18 * i, 49, 10, 10, 1);
        else
            gdDrawFilledRect(5 + 18 * i, 49, 10, 10, 0);
    }
#endif
}
#endif

void showBrWork(void)
{
    showParLabel(LABEL_BR_WORK);
    showBar(MIN_BRIGHTNESS, MAX_BRIGHTNESS, brWork);
#if defined(_KS0066)
    ks0066SetXY(13, 0);
    writeNum(brWork, 3, ' ', 10);
#elif defined(_LS020)
    showParValue(brWork);
    drawBarSpectrum();
    showParIcon(ICON24_BRIGHTNESS);
#else
    showParValue(brWork);
    drawBarSpectrum();
    showParIcon(ICON24_BRIGHTNESS);
#endif
}

void showRadio(uint8_t tune)
{
    tunerReadStatus();

    uint8_t i;

    uint8_t level = tunerLevel();
    uint8_t num = tunerStationNum();
    uint8_t favNum = tunerFavStationNum();
#ifdef _RDS
    uint8_t rdsFlag = rdsGetFlag();
#endif

#if defined(_KS0066)
    lcdGenBar(SYM_STEREO_MONO);

    // Frequency value
    ks0066SetXY(0, 0);
    writeString("FM ");
    writeNum(tuner.rdFreq / 100, 3, ' ', 10);
    ks0066WriteData('.');
    writeNum(tuner.rdFreq % 100, 2, '0', 10);

    // Signal level
    ks0066SetXY(12, 0);
    level = level * 2 / 5;
    if (level < 3) {
        ks0066WriteData(level);
        ks0066WriteData(0x00);
    } else {
        ks0066WriteData(0x03);
        ks0066WriteData(level > 6 ? 0x03 : level - 3);
    }

    // Stereo indicator
    ks0066SetXY(10, 0);
    if (tuner.mono)
        writeString("\x07");
    else if (tunerStereo())
        writeString("\x06");
    else
        writeString(" ");

    // Favourite station number
    ks0066SetXY(15, 0);
    if (favNum) {
        writeNum(favNum - 1, 1, ' ', 10);
    } else {
        writeString("-");
    }

    // Station number
    ks0066SetXY(14, 1);
    if (num) {
        writeNum(num, 2, ' ', 10);
    } else {
        writeString("--");
    }

    // Select between RDS and spectrum mode
#ifdef _RDS
    if (rdsFlag) {
        // RDS data
        ks0066SetXY(0, 1);
        writeString("RDS:");
        writeString(rdsGetText ());
    } else {
#endif
        // Frequency scale
        uint8_t value = (int16_t)36 * ((tuner.rdFreq - tuner.fMin) >> 4) / ((tuner.fMax - tuner.fMin) >> 4);
        ks0066SetXY(0, 1);
        for (i = 0; i < 12; i++) {
            if (value / 3 > i) {
                ks0066WriteData(0x03);
            } else {
                if (value / 3 < i) {
                    ks0066WriteData(0x00);
                } else {
                    ks0066WriteData(value % 3);
                }
            }
        }
#ifdef _RDS
    }
#endif

    // Tune status
    ks0066SetXY (12, 1);
    if (tune == MODE_RADIO_TUNE) {
        writeString("<>");
    } else {
        writeString("  ");
    }
#elif defined(_LS020)
    // Frequency value
    ls020SetXY(8, 2);
    ls020LoadFont(font_ks0066_ru_24, COLOR_CYAN, 2);
    writeNum(tuner.rdFreq / 100, 3, ' ', 10);
    writeStringPgm(STR_SPDOTSP);
    writeNum(tuner.rdFreq % 100, 2, '0', 10);

    // Signal level
    for (i = 0; i < 16; i += 2) {
        if (i <= level) {
            ls020DrawVertLine(158 + i, 9, 9 - i / 2, COLOR_CYAN);
        } else {
            ls020DrawVertLine(158 + i, 8, 0, COLOR_BLACK);
            ls020DrawPixel(158 + i, 9, COLOR_CYAN);
        }
    }

    // Stereo indicator
    ls020LoadFont(font_ks0066_ru_08, COLOR_CYAN, 1);
    ls020SetXY(162, 15);
    if (tuner.mono)
        writeStringPgm(STR_MONO);
    else if (tunerStereo())
        writeStringPgm(STR_STEREO);
    else
        writeStringPgm(STR_SPACE2);

    // Favourite station number
    ls020LoadFont(font_ks0066_ru_24, COLOR_CYAN, 1);
    ls020SetXY(162, 24);
    if (favNum)
        writeNum(favNum - 1, 1, ' ', 10);
    else
        writeStringPgm(STR_MINUS1);

    // Station number
    ls020LoadFont(font_digits_32, COLOR_CYAN, 1);
    ls020SetXY(126, 88);
    if (num)
        writeNum(num, 3, ' ', 10);
    else
        writeStringPgm(STR_SPMINUS2);

    // Frequency scale
    showBar(tuner.fMin >> 4, tuner.fMax >> 4, tuner.rdFreq >> 4);

    // Select between RDS and spectrum mode
#ifdef _RDS
    if (rdsFlag) {
        ls020LoadFont(font_ks0066_ru_24, COLOR_CYAN, 1);
        ls020SetXY(4, 104);
        writeString(rdsGetText());
        ls020DrawRect(ls020GetX(), 40, 103 - ls020GetX(), 24, 0);
    } else {
#endif
        drawBarSpectrum();
#ifdef _RDS
    }
#endif

    ls020LoadFont(font_ks0066_ru_08, COLOR_CYAN, 1);
    if (tune == MODE_RADIO_TUNE) {
        ls020SetXY(148, 121);
        writeStringPgm(STR_TUNE);
    } else {
        ls020SetXY(80, 80);
        if (tuner.rds) {
            if (rdsFlag)
                writeStringPgm(STR_RDS);
            else
                writeStringPgm(STR_RC_NONE);
        } else {
            writeStringPgm(STR_SPACE3);
        }
    }
#else
    // Frequency value
    gdLoadFont(font_ks0066_ru_24, 1, FONT_DIR_0);
    gdSetXY(0, 0);
    writeStringPgm(STR_FM);
    writeNum(tuner.rdFreq / 100, 3, ' ', 10);
    writeStringPgm(STR_SPDOTSP);
    writeNum(tuner.rdFreq % 100, 2, '0', 10);

    // Signal level
    for (i = 0; i < 16; i += 2) {
        if (i <= level) {
            gdDrawLine(112 + i, 7, 112 + i, 7 - i / 2, 0x01);
        } else {
            gdDrawLine(112 + i, 6, 112 + i, 0, 0x00);
            gdDrawPixel(112 + i, 7, 0x01);
        }
    }

    // Stereo indicator
    gdLoadFont(font_ks0066_ru_08, 1, FONT_DIR_0);
    gdSetXY(116, 12);
    if (tuner.mono)
        writeStringPgm(STR_MONO);
    else if (tunerStereo())
        writeStringPgm(STR_STEREO);
    else
        writeStringPgm(STR_SPACE2);

    // Favourite station number
    gdSetXY(122, 23);
    if (favNum)
        writeNum(favNum - 1, 1, ' ', 10);
    else
        writeStringPgm(STR_MINUS1);

    // Station number
    gdLoadFont(font_ks0066_ru_24, 1, FONT_DIR_0);
    gdSetXY(106, 30);
    if (num)
        writeNum(num, 2, ' ', 10);
    else
        writeStringPgm(STR_MINUS2);

    // Frequency scale
    showBar(tuner.fMin >> 4, tuner.fMax >> 4, tuner.rdFreq >> 4);

    // Select between RDS and spectrum mode
#ifdef _RDS
    if (rdsFlag) {
        gdLoadFont(font_ks0066_ru_24, 1, FONT_DIR_0);
        gdSetFontFixed(12);
        gdSetXY(0, 40);
        writeString(rdsGetText());
    } else {
        gdDrawFilledRect(93, 40, 3, 24, 0);
#endif
        drawBarSpectrum();
#ifdef _RDS
    }
#endif

    gdLoadFont(font_ks0066_ru_08, 1, FONT_DIR_0);
    if (tune == MODE_RADIO_TUNE) {
        gdSetXY(108, 56);
        writeStringPgm(STR_TUNE);
    } else {
        gdSetXY(110, 56);
#ifdef _RDS
        if (tuner.rds) {
            if (rdsFlag)
                writeStringPgm(STR_RDS);
            else
                writeStringPgm(STR_RC_NONE);
        } else {
            writeStringPgm(STR_SPACE3);
        }
#else
        writeStringPgm(STR_SPACE3);
#endif
    }
#endif
}

void showRcInfo(void)
{
    IRData irBuf = getIrData();
    uint16_t btnBuf = getBtnBuf();
    uint8_t encBuf = getEncBuf();

#if defined(_KS0066)
    ks0066SetXY(0, 0);
    writeString("I=");
    writeNum(btnBuf + encBuf, 2, '0', 16);
    writeString(" ");
    writeStringPgm((const char *)pgm_read_word(&rcLabels[rcIndex]));

    ks0066SetXY(0, 1);
    writeString("A=");
    writeNum(irBuf.address, 2, '0', 16);
    writeString(" C=");
    writeNum(irBuf.command, 2, '0', 16);
    writeString(" T=");
    switch (irBuf.type) {
    case IR_TYPE_RC5:
        writeStringPgm(STR_RC_RC5);
        break;
    case IR_TYPE_NEC:
        writeStringPgm(STR_RC_NEC);
        break;
    case IR_TYPE_RC6:
        writeStringPgm(STR_RC_RC6);
        break;
    case IR_TYPE_SAM:
        writeStringPgm(STR_RC_SAM);
        break;
    default:
        writeStringPgm(STR_RC_NONE);
        break;
    }
#elif defined(_LS020)
    ls020LoadFont(font_ks0066_ru_08, COLOR_CYAN, 1);
    ls020SetXY(10, 4);
    writeStringPgm(STR_IN_STATUS);

    ls020SetXY(4, 22);
    writeStringPgm(STR_BUTTONS);
    ls020LoadFont(font_ks0066_ru_08, COLOR_CYAN, 2);
    ls020SetXY(60, 18);
    writeNum(btnBuf >> 2, 5, '0', 2);
    writeStringPgm(STR_SPDIVSP);
    writeNum(encBuf, 2, '0', 2);

    ls020LoadFont(font_ks0066_ru_08, COLOR_CYAN, 1);
    ls020SetXY(10, 46);
    writeStringPgm(STR_LEARN);

    ls020SetXY(4, 66);
    writeStringPgm(STR_REMOTE);
    ls020LoadFont(font_ks0066_ru_08, COLOR_CYAN, 2);
    ls020SetXY(60, 62);
    switch (irBuf.type) {
    case IR_TYPE_RC5:
        writeStringPgm(STR_RC_RC5);
        break;
    case IR_TYPE_NEC:
        writeStringPgm(STR_RC_NEC);
        break;
    case IR_TYPE_RC6:
        writeStringPgm(STR_RC_RC6);
        break;
    case IR_TYPE_SAM:
        writeStringPgm(STR_RC_SAM);
        break;
    default:
        writeStringPgm(STR_RC_NONE);
        break;
    }

    ls020LoadFont(font_ks0066_ru_08, COLOR_CYAN, 1);
    ls020SetXY(4, 84);
    writeStringPgm(STR_ADDRESS);
    ls020LoadFont(font_ks0066_ru_08, COLOR_CYAN, 2);
    ls020SetXY(60, 82);
    writeNum(irBuf.address, 2, '0', 16);
    writeStringPgm(STR_SPARRSP);
    writeNum(eeprom_read_byte((uint8_t *)EEPROM_RC_ADDR), 2, '0', 16);

    ls020LoadFont(font_ks0066_ru_08, COLOR_CYAN, 1);
    ls020SetXY(4, 102);
    writeStringPgm(STR_FUNCTION);
    ls020SetXY(60, 102);
    writeStringPgm((const char *)pgm_read_word(&rcLabels[rcIndex]));

    ls020SetXY(4, 118);
    writeStringPgm(STR_COMMAND);
    ls020LoadFont(font_ks0066_ru_08, COLOR_CYAN, 2);
    ls020SetXY(60, 114);
    writeNum(irBuf.command, 2, '0', 16);
    writeStringPgm(STR_SPARRSP);
    writeNum(eeprom_read_byte((uint8_t *)EEPROM_RC_CMD + rcIndex), 2, '0', 16);
#else
    gdLoadFont(font_ks0066_ru_08, 1, FONT_DIR_0);
    gdSetXY(10, 0);
    writeStringPgm(STR_IN_STATUS);

    gdSetXY(0, 10);
    writeStringPgm(STR_BUTTONS);
    gdSetXY(48, 10);
    writeStringPgm(STR_PREFIX_HEX);
    writeNum(btnBuf, 4, '0', 16);
    writeStringPgm(STR_SPDIVSP);
    writeStringPgm(STR_PREFIX_BIN);
    writeNum(encBuf, 2, '0', 2);

    gdSetXY(10, 20);
    writeStringPgm(STR_LEARN);

    gdSetXY(0, 30);
    writeStringPgm(STR_REMOTE);
    gdSetXY(48, 30);
    switch (irBuf.type) {
    case IR_TYPE_RC5:
        writeStringPgm(STR_RC_RC5);
        break;
    case IR_TYPE_NEC:
        writeStringPgm(STR_RC_NEC);
        break;
    case IR_TYPE_RC6:
        writeStringPgm(STR_RC_RC6);
        break;
    case IR_TYPE_SAM:
        writeStringPgm(STR_RC_SAM);
        break;
    default:
        writeStringPgm(STR_RC_NONE);
        break;
    }

    gdSetXY(0, 39);
    writeStringPgm(STR_ADDRESS);
    gdSetXY(48, 39);
    writeStringPgm(STR_PREFIX_HEX);
    writeNum(irBuf.address, 2, '0', 16);
    writeStringPgm(STR_SPARRSP);
    writeStringPgm(STR_PREFIX_HEX);
    writeNum(eeprom_read_byte((uint8_t *)EEPROM_RC_ADDR), 2, '0', 16);

    gdSetXY(0, 48);
    writeStringPgm(STR_FUNCTION);
    gdSetXY(48, 48);
    writeStringPgm((const char *)pgm_read_word(&rcLabels[rcIndex]));

    gdSetXY(0, 57);
    writeStringPgm(STR_COMMAND);
    gdSetXY(48, 57);
    writeStringPgm(STR_PREFIX_HEX);
    writeNum(irBuf.command, 2, '0', 16);
    writeStringPgm(STR_SPARRSP);
    writeStringPgm(STR_PREFIX_HEX);
    writeNum(eeprom_read_byte((uint8_t *)EEPROM_RC_CMD + rcIndex), 2, '0', 16);
#endif
}

#ifdef _TEMPCONTROL
void showTemp(void)
{
    int8_t tempTH = getTempTH();
#if defined(_KS0066)
    lcdGenBar (SYM_STEREO_DEGREE);
    ks0066SetXY (0, 0);
    writeStringPgm(STR_THRESHOLD);
    showParValue (tempTH);
    writeString("\x07""C");

    ks0066SetXY (0, 1);
    writeString("1:");
    writeNum(ds18x20GetTemp(0) / 10, 3, ' ', 10);
    writeString("\x07""C");
    writeString("  2:");
    writeNum(ds18x20GetTemp(1) / 10, 3, ' ', 10);
    writeString("\x07""C");
#elif defined(_LS020)
    ls020LoadFont(font_ks0066_ru_08, COLOR_CYAN, 2);

    ls020SetXY(2, 28 + 68);
    writeStringPgm(STR_SENSOR1);
    writeNum(ds18x20GetTemp(0) / 10, 3, ' ', 10);
    writeStringPgm(STR_DEGREE);

    ls020SetXY(2, 48 + 68);
    writeStringPgm(STR_SENSOR2);
    writeNum(ds18x20GetTemp(1) / 10, 3, ' ', 10);
    writeStringPgm(STR_DEGREE);

    showParValue(tempTH);
    showBar(MIN_TEMP, MAX_TEMP, tempTH);
    ls020LoadFont(font_ks0066_ru_24, COLOR_CYAN, 1);
    ls020SetXY(2, 0);
    writeStringPgm(STR_THRESHOLD);
    showParIcon(ICON24_THRESHOLD);
#else
    gdLoadFont(font_ks0066_ru_08, 1, FONT_DIR_0);

    gdSetXY(0, 48);
    writeStringPgm(STR_SENSOR1);
    writeNum(ds18x20GetTemp(0) / 10, 3, ' ', 10);
    writeStringPgm(STR_DEGREE);

    gdSetXY(0, 56);
    writeStringPgm(STR_SENSOR2);
    writeNum(ds18x20GetTemp(1) / 10, 3, ' ', 10);
    writeStringPgm(STR_DEGREE);

    showParValue(tempTH);
    showBar(MIN_TEMP, MAX_TEMP, tempTH);
    gdLoadFont(font_ks0066_ru_24, 1, FONT_DIR_0);
    gdSetXY(0, 0);
    writeStringPgm(STR_THRESHOLD);
    showParIcon(ICON24_THRESHOLD);

#endif
}
#endif

void showTime(void)
{
#if defined(_KS0066)
    ks0066SetXY(0, 0);
    drawTm (RTC_HOUR);
    ks0066WriteData (':');
    drawTm (RTC_MIN);
    ks0066WriteData (':');
    drawTm (RTC_SEC);

    ks0066SetXY(11, 0);
    drawTm(RTC_DATE);
    ks0066WriteData('.');
    drawTm(RTC_MONTH);

    ks0066SetXY(12, 1);
    ks0066WriteString("20");
    drawTm(RTC_YEAR);

    ks0066SetXY(0, 1);
#elif defined(_LS020)
    ls020SetXY(2, 4);

    drawTm(RTC_HOUR, font_ks0066_ru_24, 2);
    writeStringPgm(STR_SPCOLSP);
    drawTm(RTC_MIN, font_ks0066_ru_24, 2);
    writeStringPgm(STR_SPCOLSP);
    drawTm(RTC_SEC, font_ks0066_ru_24, 2);

    ls020SetXY(12, 64);

    drawTm(RTC_DATE, font_digits_32, 1);
    writeStringPgm(STR_SPDOTSP);
    drawTm(RTC_MONTH, font_digits_32, 1);
    writeStringPgm(STR_SPDOTSP);
    if (rtc.etm == RTC_YEAR)
        ls020LoadFont(font_digits_32, COLOR_YELLOW, 1);
    writeStringPgm(STR_YEAR20);
    writeStringPgm(STR_SP);
    drawTm(RTC_YEAR, font_digits_32, 1);

    ls020LoadFont(font_ks0066_ru_24, COLOR_CYAN, 1);
    ls020SetXY(24, 104);
#else
    gdSetXY(4, 0);

    drawTm(RTC_HOUR, font_digits_32);
    writeStringPgm(STR_SPCOLSP);
    drawTm(RTC_MIN, font_digits_32);
    writeStringPgm(STR_SPCOLSP);
    drawTm(RTC_SEC, font_digits_32);

    gdSetXY(9, 32);

    drawTm(RTC_DATE, font_ks0066_ru_24);
    writeStringPgm(STR_SPDOTSP);
    drawTm(RTC_MONTH, font_ks0066_ru_24);
    writeStringPgm(STR_SPDOTSP);
    if (rtc.etm == RTC_YEAR)
        gdLoadFont(font_ks0066_ru_24, 0, FONT_DIR_0);
    writeStringPgm(STR_YEAR20);
    writeStringPgm(STR_SP);
    drawTm(RTC_YEAR, font_ks0066_ru_24);

    gdLoadFont(font_ks0066_ru_08, 1, FONT_DIR_0);
    gdSetXY(32, 56);
#endif
    writeStringEeprom(txtLabels[LABEL_SUNDAY + (rtcWeekDay() - 1) % 7]);
}

void showTimer(int16_t timer)
{
#if defined(_KS0066)
    ks0066SetXY(0, 0);
    writeStringEeprom(txtLabels[LABEL_TIMER]);

    ks0066SetXY(8, 0);

    if (timer >= 0) {
        writeNum(timer / 3600, 2, '0', 10);
        writeString(":");
        writeNum(timer / 60 % 60, 2, '0', 10);
        writeString(":");
        writeNum(timer % 60, 2, '0', 10);
    } else {
        writeString("--");
        writeString(":");
        writeString("--");
        writeString(":");
        writeString("--");
    }
    drawMiniSpectrum();
#elif defined(_LS020)
    uint8_t x, xbase;
    uint8_t ybase;

    ls020SetXY(2, 4);

    ls020LoadFont(font_ks0066_ru_24, COLOR_CYAN, 2);
    if (timer >= 0) {
        writeNum(timer / 3600, 2, '0', 10);
        writeStringPgm(STR_SPCOLSP);
        writeNum(timer / 60 % 60, 2, '0', 10);
        writeStringPgm(STR_SPCOLSP);
        writeNum(timer % 60, 2, '0', 10);
    } else {
        writeStringPgm(STR_MINUS2);
        writeStringPgm(STR_SPCOLSP);
        writeStringPgm(STR_MINUS2);
        writeStringPgm(STR_SPCOLSP);
        writeStringPgm(STR_MINUS2);
    }

    for (x = 0; x < LS020_HEIGHT / 6 + 1; x++) {
        xbase = x * 6;

        ybase = buf[x] + buf[x + 32];
        drawSpCol(xbase, 2, 131, 2 * ybase, 80);
        ybase += buf[x + 1] + buf[x + 32 + 1];
        ybase /= 2;
        drawSpCol(xbase + 3, 2, 131, 2 * ybase, 80);
    }
#else
    uint8_t x, xbase;
    uint8_t ybase;

    gdSetXY(4, 0);

    gdLoadFont(font_digits_32, 1, FONT_DIR_0);
    if (timer >= 0) {
        writeNum(timer / 3600, 2, '0', 10);
        writeStringPgm(STR_SPCOLSP);
        writeNum(timer / 60 % 60, 2, '0', 10);
        writeStringPgm(STR_SPCOLSP);
        writeNum(timer % 60, 2, '0', 10);
    } else {
        writeStringPgm(STR_MINUS2);
        writeStringPgm(STR_SPCOLSP);
        writeStringPgm(STR_MINUS2);
        writeStringPgm(STR_SPCOLSP);
        writeStringPgm(STR_MINUS2);
    }

    for (x = 0; x < GD_SIZE_X / 4; x++) {
        xbase = x << 2;

        ybase = (buf[x] + buf[x + 32]) / 2;
        drawSpCol(xbase, 3, 63, ybase, 31);
    }
#endif
}

void showSpectrum(void)
{
    uint8_t left = 0;
    uint8_t right = 0;
    uint8_t data;

    if (spMode == SP_MODE_METER) {
        data = 0;
        for (uint8_t i = 0; i < FFT_SIZE / 2 - 1; i++) {
            data = buf[i] + buf[i + 1];
            if (data > left) {
                left = data;
            }
        }
        data = 0;
        for (uint8_t i = 0; i < FFT_SIZE / 2 - 1; i++) {
            data = buf[i + FFT_SIZE / 2] + buf[i + FFT_SIZE / 2 + 1];
            if (data > right) {
                right = data;
            }
        }

    }

#if defined(_KS0066)
    uint8_t i;

    switch (spMode) {
    case SP_MODE_STEREO:
        lcdGenLevels();
        ks0066SetXY(0, 0);
        for (i = 0; i < KS0066_SCREEN_WIDTH; i++) {
            data = buf[i] >> 2;
            if (data >= 7)
                data = 0xFF;
            ks0066WriteData(data);
        }
        ks0066SetXY(0, 1);
        for (i = 0; i < KS0066_SCREEN_WIDTH; i++) {
            data = buf[FFT_SIZE / 2 + i] >> 2;
            if (data >= 7)
                data = 0xFF;
            ks0066WriteData(data);
        }
        break;
    case SP_MODE_MIXED:
        lcdGenLevels();
        for (i = 0; i < KS0066_SCREEN_WIDTH; i++) {
            data = buf[i];
            data += buf[FFT_SIZE / 2 + i];
            data >>= 2;
            ks0066SetXY(i, 0);
            if (data < 8)
                ks0066WriteData(' ');
            else if (data < 15)
                ks0066WriteData(data - 8);
            else
                ks0066WriteData(0xFF);
            ks0066SetXY(i, 1);
            if (data < 7)
                ks0066WriteData(data);
            else
                ks0066WriteData(0xFF);
        }
        break;
    default:
        lcdGenBar(userAddSym);

        ks0066SetXY(0, 0);
        ks0066WriteData(eeprom_read_byte(txtLabels[LABEL_LEFT_CHANNEL]));
        for (i = 0; i < KS0066_SCREEN_WIDTH - 1; i++) {
            if (left / 3 > i) {
                ks0066WriteData(0x03);
            } else {
                if (left / 3 < i) {
                    ks0066WriteData(0x00);
                } else {
                    ks0066WriteData(left % 3);
                }
            }
        }
        ks0066SetXY(0, 1);
        ks0066WriteData(eeprom_read_byte(txtLabels[LABEL_RIGHT_CHANNEL]));
        for (i = 0; i < KS0066_SCREEN_WIDTH - 1; i++) {
            if (right / 3 > i) {
                ks0066WriteData(0x03);
            } else {
                if (right / 3 < i) {
                    ks0066WriteData(0x00);
                } else {
                    ks0066WriteData(right % 3);
                }
            }
        }
        break;
    }
#elif defined(_LS020)
    uint8_t x, xbase;
    uint8_t ybase;

    switch (spMode) {
    case SP_MODE_STEREO:
        for (x = 0; x < LS020_HEIGHT / 6 + 1; x++) {
            xbase = x * 6;

            ybase = buf[x];
            drawSpCol(xbase, 2, 65, 2 * ybase, 65);
            ybase += buf[x + 1];
            ybase /= 2;
            drawSpCol(xbase + 3, 2, 65, 2 * ybase, 65);

            ybase = buf[x + 32];
            drawSpCol(xbase, 2, 131, 2 * ybase, 65);
            ybase += buf[x + 32 + 1];
            ybase /= 2;
            drawSpCol(xbase + 3, 2, 131, 2 * ybase, 65);
        }
        break;
    case SP_MODE_MIXED:
        for (x = 0; x < LS020_HEIGHT / 6 + 1; x++) {
            xbase = x * 6;

            ybase = buf[x] + buf[x + 32];
            drawSpCol(xbase, 2, 131, 2 * ybase, 131);
            ybase += buf[x + 1] + buf[x + 32 + 1];
            ybase /= 2;
            drawSpCol(xbase + 3, 2, 131, 2 * ybase, 131);
        }
        break;
    default:
        ls020LoadFont(font_ks0066_ru_08, COLOR_CYAN, 1);
        ls020SetXY(2, 4);
        writeStringEeprom(txtLabels[LABEL_LEFT_CHANNEL]);
        ls020SetXY(2, 80);
        writeStringEeprom(txtLabels[LABEL_RIGHT_CHANNEL]);

        for (x = 0; x < 58; x++) {
            ls020DrawRect(3 * x + 1, 20, 3 * x + 2, 29, x < left ? COLOR_YELLOW : COLOR_BLACK);
            ls020DrawRect(3 * x + 1, 30, 3 * x + 2, 30, COLOR_YELLOW);
            ls020DrawRect(3 * x + 1, 31, 3 * x + 2, 40, x < left ? COLOR_YELLOW : COLOR_BLACK);

            ls020DrawRect(3 * x + 1, 96, 3 * x + 2, 105, x < right ? COLOR_YELLOW : COLOR_BLACK);
            ls020DrawRect(3 * x + 1, 106, 3 * x + 2, 106, COLOR_YELLOW);
            ls020DrawRect(3 * x + 1, 107, 3 * x + 2, 116, x < right ? COLOR_YELLOW : COLOR_BLACK);
        }
        break;
    }
#else
    uint8_t xbase, ybase;

    switch (spMode) {
    case SP_MODE_STEREO:
        for (uint8_t i = 0; i < GD_SIZE_X / 6 + 1; i++) {
            xbase = i * 6;

            for (uint8_t y = 0; y < GD_SIZE_Y; y += 32) {
                ybase = buf[i + y];
                drawSpCol(xbase, 2, 31 + y, ybase, 31);
                ybase += buf[i + y + 1];
                ybase /= 2;
                drawSpCol(xbase + 3, 2, 31 + y, ybase, 31);
            }
        }
        break;
    case SP_MODE_MIXED:
        for (uint8_t i = 0; i < GD_SIZE_X / 6 + 1; i++) {
            xbase = i * 6;

            ybase = buf[i] + buf[i + 32];
            drawSpCol(xbase, 2, 63, ybase, 63);
            ybase += buf[i + 1] + buf[i + 32 + 1];
            ybase /= 2;
            drawSpCol(xbase + 3, 2, 63, ybase, 63);
        }
        break;
    default:
        gdLoadFont(font_ks0066_ru_08, 1, FONT_DIR_0);
        gdSetXY(0, 0);
        writeStringEeprom(txtLabels[LABEL_LEFT_CHANNEL]);
        gdSetXY(0, 36);
        writeStringEeprom(txtLabels[LABEL_RIGHT_CHANNEL]);

        // Scale range 0..62 to 0..42
        left = left * 2 / 3;
        right = right * 2 / 3;

        for (uint8_t i = 0; i < 43; i++) {
            for (uint8_t y = 12; y < 27; y++) {
                if (i < left || y == 19) {
                    gdDrawPixel(3 * i + 0, y, 1);
                    gdDrawPixel(3 * i + 1, y, 1);
                } else {
                    gdDrawPixel(3 * i + 0, y, 0);
                    gdDrawPixel(3 * i + 1, y, 0);
                }
            }
            for (uint8_t y = 48; y < 63; y++) {
                if (i < right || y == 55) {
                    gdDrawPixel(3 * i + 0, y, 1);
                    gdDrawPixel(3 * i + 1, y, 1);
                } else {
                    gdDrawPixel(3 * i + 0, y, 0);
                    gdDrawPixel(3 * i + 1, y, 0);
                }
            }
        }
        break;
    }
#endif
}


void showEffect3d(void)
{
    showParLabel(LABEL_EFFECT_3D);
    drawMiniSpectrum();
#if defined(_KS0066)
    lcdGenBar(SYM_EFFECT_3D_CROSS);
    ks0066SetXY(14, 0);
    ks0066WriteData(0x06);
    if (aproc.extra & APROC_EXTRA_EFFECT3D)
        ks0066WriteData(' ');
    else
        ks0066WriteData(0x07);
#elif defined(_LS020)
    ls020SetXY(96, 32);
    if (aproc.extra & APROC_EXTRA_EFFECT3D)
        ls020WriteIcon32(ICON32_EFFECT_3D_ON);
    else
        ls020WriteIcon32(ICON32_EFFECT_3D_OFF);
#else
    gdSetXY(96, 32);
    if (aproc.extra & APROC_EXTRA_EFFECT3D)
        gdWriteIcon32(ICON32_EFFECT_3D_ON);
    else
        gdWriteIcon32(ICON32_EFFECT_3D_OFF);
#endif
}

void showLoudness(void)
{
    showParLabel(LABEL_LOUDNESS);
    drawMiniSpectrum();
#if defined(_KS0066)
    lcdGenBar(SYM_LOUDNESS_CROSS);
    ks0066SetXY(14, 0);
    ks0066WriteData(0x06);
    if (aproc.extra & APROC_EXTRA_LOUDNESS)
        ks0066WriteData(' ');
    else
        ks0066WriteData(0x07);
#elif defined(_LS020)
    ls020SetXY(96, 32);
    if (aproc.extra & APROC_EXTRA_LOUDNESS)
        ls020WriteIcon32(ICON32_LOUDNESS_ON);
    else
        ls020WriteIcon32(ICON32_LOUDNESS_OFF);
#else
    gdSetXY(96, 32);
    if (aproc.extra & APROC_EXTRA_LOUDNESS)
        gdWriteIcon32(ICON32_LOUDNESS_ON);
    else
        gdWriteIcon32(ICON32_LOUDNESS_OFF);
#endif
}

void showMute(void)
{
    showParLabel(LABEL_MUTE);
    drawMiniSpectrum();

#if defined(_KS0066)
    lcdGenBar(SYM_MUTE_CROSS);
    ks0066SetXY(14, 0);
    ks0066WriteData(0x06);
    if (aproc.mute)
        ks0066WriteData(0x07);
    else
        ks0066WriteData(' ');
#elif defined(_LS020)
    ls020SetXY(96, 32);
    if (aproc.mute)
        ls020WriteIcon32(ICON32_MUTE_ON);
    else
        ls020WriteIcon32(ICON32_MUTE_OFF);
#else
    gdSetXY(96, 32);
    if (aproc.mute)
        gdWriteIcon32(ICON32_MUTE_ON);
    else
        gdWriteIcon32(ICON32_MUTE_OFF);
#endif
}

void showSurround(void)
{
    showParLabel(LABEL_SURROUND);
    drawMiniSpectrum();
#if defined(_KS0066)
    lcdGenBar(SYM_SURROUND_CROSS);
    ks0066SetXY(14, 0);
    ks0066WriteData(0x06);
    if (aproc.extra & APROC_EXTRA_SURROUND)
        ks0066WriteData(' ');
    else
        ks0066WriteData(0x07);
#elif defined(_LS020)
    ls020SetXY(96, 32);
    if (aproc.extra & APROC_EXTRA_SURROUND)
        ls020WriteIcon32(ICON32_SURROUND_ON);
    else
        ls020WriteIcon32(ICON32_SURROUND_OFF);
#else
    gdSetXY(96, 32);
    if (aproc.extra & APROC_EXTRA_SURROUND)
        gdWriteIcon32(ICON32_SURROUND_ON);
    else
        gdWriteIcon32(ICON32_SURROUND_OFF);
#endif
}

void showToneBypass(void)
{
    showParLabel(LABEL_TONE_BYPASS);
    drawMiniSpectrum();
#if defined(_KS0066)
    lcdGenBar(SYM_TONE_BYPASS_CROSS);
    ks0066SetXY(14, 0);
    ks0066WriteData(0x06);
    if (aproc.extra & APROC_EXTRA_TONE_BYPASS)
        ks0066WriteData(0x07);
    else
        ks0066WriteData(' ');
#elif defined(_LS020)
    ls020SetXY(96, 32);
    if (aproc.extra & APROC_EXTRA_TONE_BYPASS)
        ls020WriteIcon32(ICON32_TONE_BYPASS_ON);
    else
        ls020WriteIcon32(ICON32_TONE_BYPASS_OFF);
#else
    gdSetXY(96, 32);
    if (aproc.extra & APROC_EXTRA_TONE_BYPASS)
        gdWriteIcon32(ICON32_TONE_BYPASS_ON);
    else
        gdWriteIcon32(ICON32_TONE_BYPASS_OFF);
#endif
}


void showSndParam(sndMode mode)
{
    sndParam *param = &sndPar[mode];

    showParLabel(mode);
    showParValue(((int16_t)(param->value) * (int8_t)pgm_read_byte(&param->grid->step) + 4) >> 3);
    showBar((int8_t)pgm_read_byte(&param->grid->min), (int8_t)pgm_read_byte(&param->grid->max),
            param->value);
#if defined(_KS0066)
    ks0066SetXY(14, 0);
#elif defined(_LS020)
    drawBarSpectrum();
    showParIcon(mode);
    ls020LoadFont(font_ks0066_ru_08, COLOR_CYAN, 1);
    ls020SetXY(162, 120);
#else
    drawBarSpectrum();
    showParIcon(mode);
    gdLoadFont(font_ks0066_ru_08, 1, FONT_DIR_0);
    gdSetXY(116, 56);
#endif
    writeStringEeprom(txtLabels[LABEL_DB]);
}
