WiseLord/ampcontrol/src/display/font-ks0066-ru-08.c

#include <avr/pgmspace.h>

const uint8_t font_ks0066_ru_08[] PROGMEM = {

    0x01, // font height in bytes
    0x7F, // position of symbol-space between letters
    0xC0, // count of chars
    0x20, // ascii char offset
    0x40, // non-ascii char offset

    // char widths
    0x05, 0x01, 0x03, 0x05, 0x05, 0x05, 0x05, 0x02,
    0x03, 0x03, 0x05, 0x05, 0x02, 0x05, 0x01, 0x05,
    0x05, 0x05, 0x05, 0x05, 0x05, 0x05, 0x05, 0x05,
    0x05, 0x05, 0x01, 0x02, 0x04, 0x05, 0x04, 0x05,
    0x05, 0x05, 0x05, 0x05, 0x05, 0x05, 0x05, 0x05,
    0x05, 0x03, 0x05, 0x05, 0x04, 0x05, 0x05, 0x05,
    0x05, 0x05, 0x05, 0x05, 0x05, 0x05, 0x05, 0x05,
    0x05, 0x05, 0x05, 0x03, 0x05, 0x03, 0x05, 0x05,
    0x02, 0x05, 0x05, 0x05, 0x05, 0x05, 0x05, 0x05,
    0x05, 0x03, 0x04, 0x04, 0x03, 0x05, 0x04, 0x05,
    0x05, 0x05, 0x05, 0x05, 0x05, 0x05, 0x05, 0x05,
    0x05, 0x05, 0x05, 0x03, 0x01, 0x03, 0x05, 0x01,

    0x05, 0x05, 0x05, 0x05, 0x05, 0x05, 0x05, 0x05,
    0x05, 0x05, 0x05, 0x05, 0x05, 0x05, 0x05, 0x05,
    0x05, 0x05, 0x05, 0x04, 0x04, 0x05, 0x05, 0x04,
    0x05, 0x05, 0x04, 0x04, 0x05, 0x04, 0x04, 0x05,
    0x04, 0x05, 0x05, 0x05, 0x04, 0x05, 0x05, 0x05,
    0x05, 0x05, 0x05, 0x05, 0x00, 0x05, 0x05, 0x05,
    0x05, 0x05, 0x05, 0x05, 0x05, 0x05, 0x03, 0x03,
    0x05, 0x05, 0x05, 0x05, 0x05, 0x05, 0x05, 0x05,
    0x05, 0x05, 0x05, 0x05, 0x05, 0x05, 0x05, 0x05,
    0x03, 0x05, 0x05, 0x04, 0x03, 0x05, 0x05, 0x04,
    0x05, 0x05, 0x00, 0x00, 0x00, 0x00, 0x00, 0x00,
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
    0x7F, 0x48, 0x30, 0x00, 0x7F,
    // 175  Э
    0x22, 0x41, 0x49, 0x49, 0x3E,
    // 176  Ю
    0x7F, 0x08, 0x3E, 0x41, 0x3E,
    // 177  Я
    0x46, 0x29, 0x19, 0x09, 0x7F,
    // 178  б
    0x3C, 0x4A, 0x4A, 0x49, 0x30,
    // 179  в
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
    // 255  fill
    0xFF, 0xFF, 0xFF, 0xFF, 0xFF,

};
