WiseLord/ampcontrol/src/display/font-ks0066-ru-24.c

#include <avr/pgmspace.h>

const uint8_t font_ks0066_ru_24[] PROGMEM = {

    0x03, // font height in bytes
    0x7F, // position of symbol-space between letters
    0xC0, // count of chars
    0x20, // ascii char offset
    0x40, // non-ascii char offset

    // char widths
    0x0A, 0x02, 0x06, 0x0A, 0x0A, 0x0A, 0x0A, 0x02,
    0x05, 0x05, 0x08, 0x0A, 0x03, 0x0A, 0x02, 0x0A,
    0x0A, 0x0A, 0x0A, 0x0A, 0x0A, 0x0A, 0x0A, 0x0A,
    0x0A, 0x0A, 0x02, 0x03, 0x06, 0x0A, 0x06, 0x0A,
    0x0B, 0x0A, 0x0A, 0x0A, 0x0A, 0x0A, 0x08, 0x0A,
    0x0A, 0x06, 0x0A, 0x0A, 0x0A, 0x0B, 0x0A, 0x0A,
    0x0A, 0x0A, 0x0A, 0x0A, 0x0A, 0x0A, 0x09, 0x0B,
    0x0A, 0x0A, 0x0A, 0x04, 0x0A, 0x04, 0x09, 0x0A,
    0x03, 0x09, 0x09, 0x09, 0x09, 0x09, 0x08, 0x09,
    0x09, 0x06, 0x07, 0x09, 0x06, 0x0A, 0x09, 0x09,
    0x09, 0x09, 0x08, 0x09, 0x08, 0x09, 0x09, 0x0B,
    0x09, 0x09, 0x09, 0x05, 0x02, 0x05, 0x0A, 0x02,

    0x0A, 0x09, 0x0A, 0x0C, 0x0A, 0x0A, 0x0A, 0x0A,
    0x0A, 0x0A, 0x0A, 0x0A, 0x0A, 0x0B, 0x0B, 0x0A,
    0x0A, 0x0A, 0x09, 0x09, 0x08, 0x09, 0x0A, 0x09,
    0x09, 0x09, 0x08, 0x09, 0x09, 0x09, 0x09, 0x08,
    0x09, 0x0A, 0x09, 0x0A, 0x08, 0x09, 0x0A, 0x08,
    0x0A, 0x09, 0x0A, 0x09, 0x00, 0x0A, 0x0A, 0x09,
    0x0A, 0x09, 0x0A, 0x09, 0x0A, 0x09, 0x06, 0x06,
    0x0A, 0x09, 0x0A, 0x09, 0x0A, 0x09, 0x0A, 0x09,
    0x0C, 0x0B, 0x0C, 0x0A, 0x0A, 0x09, 0x0B, 0x0A,
    0x06, 0x0A, 0x0A, 0x09, 0x06, 0x09, 0x09, 0x08,
    0x0A, 0x09, 0x00, 0x00, 0x00, 0x00, 0x00, 0x00,
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
    // 165  И
    0xF8, 0xF8, 0x00, 0x00, 0x00, 0x00, 0x80, 0xE0, 0xF8, 0xF8,
    0xFF, 0xFF, 0x80, 0xE0, 0xF8, 0x3E, 0x0F, 0x03, 0xFF, 0xFF,
    0x3F, 0x3F, 0x0F, 0x03, 0x00, 0x00, 0x00, 0x00, 0x3F, 0x3F,
    // 166  Й
    0xF8, 0xF1, 0x03, 0x06, 0x04, 0x04, 0x86, 0xE3, 0xF9, 0xF8,
    0xFF, 0xFF, 0x80, 0xE0, 0xF8, 0x3E, 0x0F, 0x03, 0xFF, 0xFF,
    0x3F, 0x3F, 0x0F, 0x03, 0x00, 0x00, 0x00, 0x00, 0x3F, 0x3F,
    // 167  Л
    0x00, 0x00, 0xE0, 0xF0, 0x38, 0x18, 0x18, 0x18, 0xF8, 0xF8,
    0x00, 0x00, 0xFF, 0xFF, 0x00, 0x00, 0x00, 0x00, 0xFF, 0xFF,
    0x30, 0x38, 0x1F, 0x0F, 0x00, 0x00, 0x00, 0x00, 0x3F, 0x3F,
    // 168  П
    0xF8, 0xF8, 0x18, 0x18, 0x18, 0x18, 0x18, 0x18, 0xF8, 0xF8,
    0xFF, 0xFF, 0x00, 0x00, 0x00, 0x00, 0x00, 0x00, 0xFF, 0xFF,
    0x3F, 0x3F, 0x00, 0x00, 0x00, 0x00, 0x00, 0x00, 0x3F, 0x3F,
    // 169  У
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
    // 255  fill
    0xF8, 0xF8, 0xF8, 0xF8, 0xF8, 0xF8, 0xF8, 0xF8, 0xF8, 0xF8,
    0xFF, 0xFF, 0xFF, 0xFF, 0xFF, 0xFF, 0xFF, 0xFF, 0xFF, 0xFF,
    0x3F, 0x3F, 0x3F, 0x3F, 0x3F, 0x3F, 0x3F, 0x3F, 0x3F, 0x3F,

};
