WiseLord/ampcontrol/src/display/icons-24.c

#include <avr/pgmspace.h>
const uint8_t icons_24[] PROGMEM = {
    // Volume
    0xC0, 0xC0, 0xC0, 0xC0, 0xC0, 0xC0, 0x00, 0xE0, 0xF0, 0xF8, 0xFC, 0xFE,
    0xFF, 0xFF, 0x00, 0x00, 0x60, 0xE6, 0xCE, 0x9C, 0x38, 0xF0, 0xE0, 0x80,
    0xFF, 0xFF, 0xFF, 0xFF, 0xFF, 0xFF, 0x00, 0xFF, 0xFF, 0xFF, 0xFF, 0xFF,
    0xFF, 0xFF, 0x00, 0x66, 0x7E, 0x3C, 0x81, 0xFF, 0x7E, 0x00, 0xFF, 0xFF,
    0x03, 0x03, 0x03, 0x03, 0x03, 0x03, 0x00, 0x07, 0x0F, 0x1F, 0x3F, 0x7F,
    0xFF, 0xFF, 0x00, 0x00, 0x06, 0x67, 0x73, 0x39, 0x1C, 0x0F, 0x07, 0x01,
    // Bass
    0xF0, 0x18, 0x0C, 0x04, 0x06, 0x02, 0x02, 0x83, 0xC1, 0xC1, 0xC1, 0xC1,
    0x61, 0x61, 0x31, 0x31, 0x1B, 0x1A, 0x0C, 0x0C, 0x06, 0x06, 0x1B, 0xF3,
    0xFF, 0x03, 0xF6, 0xE4, 0xEC, 0x08, 0x08, 0xD9, 0xD3, 0xD3, 0xD1, 0x10,
    0x10, 0xD0, 0xD0, 0xD0, 0xD8, 0x08, 0x08, 0xE8, 0xE4, 0xF6, 0x03, 0xFF,
    0x0F, 0x18, 0x33, 0x27, 0x6F, 0x40, 0x40, 0xDF, 0x9F, 0xBF, 0xBF, 0x80,
    0x80, 0xBF, 0xBF, 0x9F, 0xDF, 0x40, 0x40, 0x6F, 0x27, 0x33, 0x18, 0x0F,
    // Middle
    0x00, 0x00, 0x00, 0x00, 0x00, 0x00, 0x00, 0x00, 0x00, 0x00, 0x80, 0x80,
    0xC3, 0xEC, 0xF0, 0xE0, 0x60, 0xE0, 0xF0, 0x3A, 0x1D, 0x0E, 0x17, 0x0B,
    0xE0, 0xF0, 0xF8, 0xFC, 0xFC, 0xB8, 0xB8, 0xDC, 0xEC, 0xFD, 0xFF, 0x7F,
    0xF7, 0xFB, 0x3D, 0x7E, 0x3F, 0x0F, 0x37, 0xC0, 0x00, 0x00, 0x00, 0x00,
    0x0F, 0x3F, 0x5F, 0x6F, 0xF3, 0xF1, 0xF9, 0xFF, 0xFF, 0xF9, 0xFE, 0x7F,
    0x3F, 0x19, 0x00, 0x00, 0x00, 0x00, 0x00, 0x00, 0x03, 0x1C, 0x38, 0x00,
    // Treble
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
    0xE0, 0x7F, 0x2A, 0xFF, 0xFF, 0x00, 0x7F, 0xE0, 0xC0, 0x00, 0x00, 0x00,
    0x00, 0x00, 0x00, 0x00, 0x00, 0x00, 0x00, 0x00, 0x00, 0x00, 0x0F, 0x3F,
    0x70, 0x66, 0xCF, 0xDF, 0xDF, 0xCF, 0x66, 0x70, 0x3F, 0x0F, 0x00, 0x00,
};
