WiseLord/ampcontrol/font-ks0066-ru-08.h

#ifndef FONTKS006RU08_H
#define FONTKS006RU08_H

#include <avr/pgmspace.h>

const uint8_t font_ks0066_ru_08[] PROGMEM = {

	0x01,	// font height in bytes
	0xC0,	// count of chars
	0x20,	// ascii char offset
	0x40,	// non-ascii char offset

	// char widths
	0x04, 0x01, 0x03, 0x05, 0x05, 0x05, 0x05, 0x02,
	0x03, 0x03, 0x05, 0x05, 0x02, 0x05, 0x01, 0x05,
	0x05, 0x05, 0x05, 0x05, 0x05, 0x05, 0x05, 0x05,
	0x05, 0x05, 0x01, 0x02, 0x04, 0x05, 0x04, 0x05,
	0x05, 0x05, 0x05, 0x05, 0x05, 0x05, 0x05, 0x05,
	0x05, 0x04, 0x05, 0x05, 0x04, 0x05, 0x05, 0x05,
	0x05, 0x05, 0x05, 0x05, 0x05, 0x05, 0x05, 0x05,
	0x05, 0x05, 0x05, 0x03, 0x05, 0x03, 0x05, 0x05,
	0x02, 0x05, 0x05, 0x05, 0x05, 0x05, 0x05, 0x05,
	0x05, 0x03, 0x04, 0x04, 0x03, 0x05, 0x04, 0x05,
	0x05, 0x05, 0x04, 0x05, 0x05, 0x05, 0x05, 0x05,
	0x05, 0x05, 0x05, 0x05, 0x05, 0x05, 0x05, 0x01,

	0x05, 0x05, 0x05, 0x05, 0x05, 0x05, 0x05, 0x05,
	0x05, 0x05, 0x05, 0x05, 0x05, 0x05, 0x05, 0x05,
	0x05, 0x05, 0x05, 0x04, 0x04, 0x05, 0x05, 0x04,
	0x05, 0x05, 0x04, 0x04, 0x05, 0x04, 0x04, 0x05,
	0x04, 0x05, 0x05, 0x05, 0x04, 0x05, 0x05, 0x05,
	0x05, 0x05, 0x05, 0x05, 0x05, 0x05, 0x05, 0x05,
	0x01, 0x01, 0x03, 0x03, 0x05, 0x05, 0x05, 0x03,
	0x05, 0x05, 0x05, 0x05, 0x05, 0x05, 0x05, 0x02,
	0x05, 0x05, 0x05, 0x05, 0x05, 0x05, 0x05, 0x01,
	0x03, 0x05, 0x05, 0x05, 0x03, 0x05, 0x05, 0x05,
	0x05, 0x05, 0x05, 0x05, 0x05, 0x05, 0x05, 0x05,
	0x05, 0x05, 0x05, 0x05, 0x05, 0x05, 0x05, 0x01,

	// font data
	0x00, 0x00, 0x00, 0x00,			/* 0x20 =>   */
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
	0x08, 0x2A, 0x7F, 0x2A, 0x08,	/* 0xFB => ⁘ */
	0x22, 0x14, 0x88, 0xFF, 0x80,	/* 0xFC => ⁙ */
	0x40, 0x9A, 0xA5, 0x59, 0x02,	/* 0xFD => § */
	0x06, 0x09, 0x7F, 0x09, 0x7F,	/* 0xFE => ¶ */
	0xFF, 0xFF, 0xFF, 0xFF, 0xFF,	/* 0xFF => █ */
};

#endif /* FONTKS006RU08_H */
