WiseLord/ampcontrol/src/display/font-digits-32.c

#include <avr/pgmspace.h>

const uint8_t font_digits_32[] PROGMEM = {

    0x04, // font height in bytes
    0x27, // position of symbol-space between letters
    0x1B, // count of chars
    0x20, // ascii char offset
    0x20, // non-ascii char offset

    // char widths
    0x0E, 0x00, 0x00, 0x00, 0x00, 0x00, 0x00, 0x02,
    0x00, 0x00, 0x00, 0x00, 0x00, 0x0E, 0x0B, 0x00,
    0x0E, 0x0E, 0x0E, 0x0E, 0x0E, 0x0E, 0x0E, 0x0E,
    0x0E, 0x0E, 0x0B,

    // font data
    // 32  space
    0x00, 0x00, 0x00, 0x00, 0x00, 0x00, 0x00, 0x00, 0x00, 0x00, 0x00, 0x00, 0x00, 0x00,
    0x00, 0x00, 0x00, 0x00, 0x00, 0x00, 0x00, 0x00, 0x00, 0x00, 0x00, 0x00, 0x00, 0x00,
    0x00, 0x00, 0x00, 0x00, 0x00, 0x00, 0x00, 0x00, 0x00, 0x00, 0x00, 0x00, 0x00, 0x00,
    0x00, 0x00, 0x00, 0x00, 0x00, 0x00, 0x00, 0x00, 0x00, 0x00, 0x00, 0x00, 0x00, 0x00,
    // 39  ltspace
    0x00, 0x00,
    0x00, 0x00,
    0x00, 0x00,
    0x00, 0x00,
    // 45  -
    0x00, 0x00, 0x00, 0x00, 0x00, 0x00, 0x00, 0x00, 0x00, 0x00, 0x00, 0x00, 0x00, 0x00,
    0xC0, 0xC0, 0xC0, 0xC0, 0xC0, 0xC0, 0xC0, 0xC0, 0xC0, 0xC0, 0xC0, 0xC0, 0xC0, 0xC0,
    0x01, 0x01, 0x01, 0x01, 0x01, 0x01, 0x01, 0x01, 0x01, 0x01, 0x01, 0x01, 0x01, 0x01,
    0x00, 0x00, 0x00, 0x00, 0x00, 0x00, 0x00, 0x00, 0x00, 0x00, 0x00, 0x00, 0x00, 0x00,
    // 46  .
    0x00, 0x00, 0x00, 0x00, 0x00, 0x00, 0x00, 0x00, 0x00, 0x00, 0x00,
    0x00, 0x00, 0x00, 0x00, 0x00, 0x00, 0x00, 0x00, 0x00, 0x00, 0x00,
    0x00, 0x00, 0x00, 0x00, 0x00, 0x00, 0x00, 0x00, 0x00, 0x00, 0x00,
    0x00, 0x00, 0x00, 0x00, 0x1C, 0x1C, 0x1C, 0x00, 0x00, 0x00, 0x00,
    // 48  0
    0xC0, 0xF0, 0xF8, 0x78, 0x3C, 0x1C, 0x1C, 0x1C, 0x1C, 0x3C, 0x78, 0xF8, 0xF0, 0xC0,
    0xFF, 0xFF, 0xFF, 0x00, 0x00, 0x00, 0x80, 0xC0, 0x60, 0x30, 0x18, 0xFF, 0xFF, 0xFF,
    0xFF, 0xFF, 0xFF, 0x0C, 0x06, 0x03, 0x01, 0x00, 0x00, 0x00, 0x00, 0xFF, 0xFF, 0xFF,
    0x03, 0x0F, 0x1F, 0x1E, 0x3C, 0x38, 0x38, 0x38, 0x38, 0x3C, 0x1E, 0x1F, 0x0F, 0x03,
    // 49  1
    0x00, 0x00, 0x00, 0xC0, 0xE0, 0xF0, 0xF8, 0xFC, 0xFC, 0x00, 0x00, 0x00, 0x00, 0x00,
    0x00, 0x00, 0x00, 0x00, 0x00, 0x00, 0xFF, 0xFF, 0xFF, 0x00, 0x00, 0x00, 0x00, 0x00,
    0x00, 0x00, 0x00, 0x00, 0x00, 0x00, 0xFF, 0xFF, 0xFF, 0x00, 0x00, 0x00, 0x00, 0x00,
    0x00, 0x00, 0x00, 0x38, 0x38, 0x38, 0x3F, 0x3F, 0x3F, 0x38, 0x38, 0x38, 0x00, 0x00,
    // 50  2
    0xC0, 0xF0, 0xF8, 0x38, 0x1C, 0x1C, 0x1C, 0x1C, 0x1C, 0x3C, 0x78, 0xF8, 0xF0, 0xC0,
    0x01, 0x01, 0x00, 0x00, 0x00, 0x00, 0x00, 0x00, 0x00, 0x80, 0xC0, 0xFF, 0xFF, 0x7F,
    0x00, 0x80, 0xC0, 0xE0, 0xF0, 0xF8, 0x7C, 0x3E, 0x1F, 0x0F, 0x07, 0x03, 0x01, 0x00,
    0x3F, 0x3F, 0x3F, 0x3B, 0x39, 0x38, 0x38, 0x38, 0x38, 0x38, 0x38, 0x38, 0x38, 0x38,
    // 51  3
    0xC0, 0xF0, 0xF8, 0x78, 0x3C, 0x1C, 0x1C, 0x1C, 0x1C, 0x3C, 0x78, 0xF8, 0xF0, 0xC0,
    0x01, 0x01, 0x00, 0x00, 0x00, 0x00, 0xC0, 0xC0, 0xE0, 0xF0, 0xF8, 0x3F, 0x1F, 0x0F,
    0x00, 0x00, 0x00, 0x00, 0x00, 0x00, 0x00, 0x00, 0x01, 0x03, 0x07, 0xFF, 0xFE, 0xFC,
    0x03, 0x0F, 0x1F, 0x1E, 0x3C, 0x38, 0x38, 0x38, 0x38, 0x38, 0x1C, 0x1F, 0x0F, 0x07,
    // 52  4
    0x00, 0x00, 0x00, 0x00, 0x00, 0x00, 0x00, 0xC0, 0xF0, 0xFC, 0xFC, 0xFC, 0x00, 0x00,
    0x00, 0x00, 0x00, 0xC0, 0xF0, 0xFC, 0x3F, 0x0F, 0x03, 0xFF, 0xFF, 0xFF, 0x00, 0x00,
    0x70, 0x7C, 0x7F, 0x7F, 0x73, 0x70, 0x70, 0x70, 0x70, 0xFF, 0xFF, 0xFF, 0x70, 0x70,
    0x00, 0x00, 0x00, 0x00, 0x00, 0x00, 0x00, 0x00, 0x00, 0x3F, 0x3F, 0x3F, 0x00, 0x00,
    // 53  5
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
};
