WiseLord/ampcontrol/src/display/st7920.h

#ifndef ST7920_H
#define ST7920_H

#include <inttypes.h>

// Basic instructions
#define ST7920_CLEAR                0x01
#define ST7920_HOME                 0x02
#define ST7920_ENTRY_MODE           0x04
#define ST7920_INC_ADDR             0x02
#define ST7920_SHIFT                0x01
#define ST7920_DISPLAY              0x08
#define ST7920_DISPLAY_ON           0x04
#define ST7920_CURSOR_ON            0x02
#define ST7920_BLINK_ON             0x01
#define ST7920_CURSOR_CTRL          0x10
#define ST7920_SHIFT_DISPLAY        0x08
#define ST7920_SHIFT_RIGHT          0x04
#define ST7920_FUNCTION             0x20
#define ST7920_8BIT                 0x10
#define ST7920_EXT_INSTR            0x04
#define ST7920_GRAPHIC              0x02 // Only with EXT_INSTR
#define ST7920_SET_CGRAM            0x40
#define ST7920_SET_DDRAM            0x80

// Extended instructions
#define ST7920_STANDBY              0x01
#define ST7920_SCROLL_RAM           0x02
#define ST7920_VERT_SCROLL          0x01
#define ST7920_REVERSE              0x04
#define ST7920_SET_IRAM_SCROLL      0x40
#define ST7920_SET_GRAPHIC_RAM      0x80

// Reading display status and address
#define ST7920_STATUS_BUSY          0x80

// Some common defines
#define ST7920_COMMAND              0
#define ST7920_DATA                 1

#define ST7920_SIZE_X               128
#define ST7920_SIZE_Y               64

#define ST7920_MIN_BRIGHTNESS       0
#define ST7920_MAX_BRIGHTNESS       32

#define ST7920_PHASE_SET_PAGE       32
#define ST7920_PHASE_SET_ADDR       33
#define ST7920_PHASE_READ_PORT      34

void st7920SetBrightness(uint8_t br);

void st7920Init(void);
void st7920Clear(void);

void st7920DrawPixel(uint8_t x, uint8_t y, uint8_t color);

uint8_t st7920GetPins(void);

#endif // ST7920_H
