WiseLord/ampcontrol/src/audio/tda7439.h

#ifndef TDA7439_H
#define TDA7439_H

#include <inttypes.h>

// I2C address
#define TDA7439_I2C_ADDR            0b10001000

// I2C function selection
#define TDA7439_INPUT_SELECT        0x00
#define TDA7439_INPUT_GAIN          0x01
#define TDA7439_PREAMP              0x02
#define TDA7439_BASS                0x03
#define TDA7439_MIDDLE              0x04
#define TDA7439_TREBLE              0x05
#define TDA7439_VOLUME_RIGHT        0x06
#define TDA7439_VOLUME_LEFT         0x07

#define TDA7439_SPEAKER_MUTE        0b01111111

// I2C autoincrement flag
#define TDA7439_AUTO_INC            0x10

// Number of inputs
#define TDA7439_IN_CNT              4

void tda7439SetSpeakers();
void tda7439SetBMT();
void tda7439SetPreamp();
void tda7439SetInput();
void tda7439SetMute();

#endif // TDA7439_H
