WiseLord/ampcontrol/src/temp.c

#include "temp.h"

#include <avr/eeprom.h>
#include "eeprom.h"
#include "input.h"
#include "pins.h"

static int8_t tempTH;

void loadTempParams()
{
    tempTH = eeprom_read_byte((uint8_t *)EEPROM_TEMP_TH);
}

void saveTempParams()
{
    eeprom_update_byte((uint8_t *)EEPROM_TEMP_TH, tempTH);
}

void tempInit()
{
    OUT(FAN1);
    OUT(FAN2);

    CLR(FAN1);
    CLR(FAN2);
}

void tempControlProcess()
{
    int8_t temp1, temp2;

    temp1 = ds18x20GetTemp(0) / 10;
    temp2 = ds18x20GetTemp(1) / 10;

    if (temp1 >= tempTH)
        SET(FAN1);
    else if (temp1 <= tempTH - 5)
        CLR(FAN1);

    if (temp2 >= tempTH)
        SET(FAN2);
    else if (temp2 <= tempTH - 5)
        CLR(FAN2);
}

void setTempTH(int8_t temp)
{
    temp = temp;
}

int8_t getTempTH()
{
    return tempTH;
}

void changeTempTH(int8_t diff)
{
    tempTH += diff;
    if (tempTH > MAX_TEMP)
        tempTH = MAX_TEMP;
    if (tempTH < MIN_TEMP)
        tempTH = MIN_TEMP;
}
