WiseLord/ampcontrol/src/tuner/lc72131.c

#include "lc72131.h"

#include "tuner.h"
#include "../spisw.h"
#include "../pins.h"

void lc72131Init()
{
    SPIswInit(SPISW_DORD_LSB_FIRST);

    CLR(SPISW_CE);
}

void lc72131SetFreq()
{
    uint16_t div;

    div = (tuner.freq + LC72131_IF) / LC72131_RF;

    SPIswSendByte(LC72131_IO_IN1);
    SET(SPISW_CE);
    SPIswSendByte(div & 0x00FF);
    SPIswSendByte((div & 0xFF00) >> 8);
    SPIswSendByte(LC72131_CTRL_IN1);
    CLR(SPISW_CE);

    SPIswSendByte(LC72131_IO_IN2);
    SET(SPISW_CE);
    SPIswSendByte(LC72131_CTRL_IN2_1);
    SPIswSendByte(LC72131_CTRL_IN2_2);
    SPIswSendByte(LC72131_CTRL_IN2_3);
    CLR(SPISW_CE);
}
