WiseLord/ampcontrol/src/tuner/lm7001.c

#include "lm7001.h"

#include "tuner.h"
#include "../spisw.h"
#include "../pins.h"

void lm7001Init()
{
    SPIswInit(SPISW_DORD_LSB_FIRST);

    CLR(SPISW_CE);
}

void lm7001SetFreq()
{
    uint16_t div;

    div = (tuner.freq + LM7001_IF) / LM7001_RF;

    SET(SPISW_CE);

    SPIswSendByte(div & 0x00FF);
    SPIswSendByte((div & 0x3F00) >> 8);
    SPIswSendByte(LM7001_CTRL_WORD);

    CLR(SPISW_CE);
}
