WiseLord/ampcontrol/tuner/rda5807m.c

#include "rda5807m.h"

#include "../i2c.h"

void rda5807mInit(void)
{
	/* TODO: Init IC */
	return;
}

static void rda5807mWriteI2C(uint8_t *buf)
{
	uint8_t i;

	I2CStart(RDA5807M_ADDR);
	for (i = 0; i < 5; i++) {
		I2CWriteByte(buf[i]);
	}
	I2CStop();

	return;
}

void rda5807mSetFreq(uint16_t freq, uint8_t mono)
{
	uint8_t buf[5];

	/* TODO: Calculate setup word and set frequency */


	rda5807mWriteI2C(buf);

	return;
}

void rda5807mReadStatus(uint8_t *buf)
{
	uint8_t i;

	I2CStart(RDA5807M_ADDR | I2C_READ);
	for (i = 0; i < 5; i++)
		I2CReadByte(&buf[i], 1);
	I2CStop();

	return;
}
