WiseLord/ampcontrol/(commit log)

2013-10-22 Apply Hamming window while read from ADC.
    This increases total speed.
2013-11-01 Added encoder polling
    Code cleanup
2013-11-22 Code refactoring
    Switched to ATmega 16
2013-11-22 FFT and ADC code optimizations
2013-11-22 Fixed error with unused RC commands
    (Pressing unused button on IR RC executed last command from used)
    [input.c, main.c]
2013-12-01 Switched to PORTA as LCD control port
2013-12-01 Fixed input number restore
    [param.c]
2013-12-03 Fixed problem with skip too fast encoder commands
    [adc.h, i2c.c, input.c, input.h, ks0108.c, main.c]
2013-12-03 Fixed bug with leading zeroes absence when time was displayed.
    [ks0108.c, ks0108.h, param.c]
2013-12-07 Fixed params save and restore
    [main.c, param.c, param.h]
2013-12-07 Fixed input switching
2013-12-23 Code adaptation to ready device
2013-12-26 Fixed issue with buttons bounce
    [input.c, input.h]
2013-12-26 Fixed IR handling, code cleanup
    [input.c, input.h, main.c, param.c, param.h]
2014-01-03 Spectrum type switch with mute button long press
2014-01-11 Hardcoded display timings replaced by polling display busy status
    [ks0108.c]
2014-01-11 Switched to new ks0108 library. At the moment only 8px font is used.
2014-01-12 Fixed 32px digit 5
    [font-digits-32.c]
2014-01-17 Changed default RC5 address.
    In BW3010/ET3010MTC-based remotes pin 14 must be connected to pin 4 (device code 0x19)
    Previously it was 14-10 connection (device code 0x10).
    Default connection is 14-3. It gives 0x00 code (default for TV)
2014-01-17 RC5 device address now is being read from EEPROM (0x0C)
2014-01-26 ADC and FFT code optimizations
2014-01-26 Device can work even with display disconnected.
    Previously it waited response from disconnected display.
2014-01-26 Switched from Hamming to Hann window
2014-01-26 Fixed ADC issue with mirroring low frequencies at high
    [adc.c]
2014-01-30 Added schematic PNG
2014-02-03 Avoid I2C endless loop when no I2C device
    [i2c.c]
2014-02-03 Added schematic and hex for WG12864B display.
    It differs from a with inverted CS1/2.
    [ks0108.h]
2014-02-12 Code refactoring.
    Double multiplier replaced to int.
    [param.c]
2014-02-19 Renamed schematics file for A displays
2014-02-25 Fixed test mode for unconfigured remote
    [input.c]
2014-02-26 Added command to switch off backlight in running mode
2014-05-04 RC5 code separated.
    Currently works only in RC5 test mode.
2014-05-04 Handle buttons code improved.
2014-05-12 Added support of RC5 digits buttons.
2014-05-12 Fixed error with display init after poweroff.
    [display.c, ks0108.c, main.c]
2014-05-24 Code refactoring. Avoid global variables.
    [adc.c, audio.c, audio.h, display.c, display.h, i2c.c, i2c.h, input.h]
2014-05-24 Replaced schematic image type A.
2014-05-28 Replace eeprom_write_ functions to eeprom_update_ to save eeprom. Save params only on exit.
    [audio.c, display.c, main.c, tuner.c]
2014-05-28 TEA5767 can work when clocked 6.5MHz or 13MHz. Fix some tuner functions. Dropped scan on TEA5767.
    [main.c, tea5767.c, tea5767.h, tuner.c, tuner.h]
2014-06-01 Switch to avr-gcc-4.8.2.
2014-06-01 Fix station number on LS020.
    [display.c]
2014-06-01 Drop FAN pin support.
2014-06-02 Revert commit 549dfa7 (Speedup spectrum on LS020 display), while without it there is a better look and feel.
    [display.c, display.h, main.c]
2014-06-02 Simplify switching to FM mode.
2014-06-03 Fixed 4bit mode for ks0066 library.
    [ks0066.c, ks0066.h]
2014-06-03 Possibility to switch FM tuner to forced mono. Only works for TEA5767.
2014-06-03 Cut eeprom files with wrong size to 512b.
2014-06-03 Fix work with original RC5 remote.
    [input.c]
2014-06-04 Fix "A" symbol width in 24px font (digits' width).
    [font-ks0066-ru-24.c]
2014-06-05 Support of KS0066 display connected via PCF8574 I2C expander.
2014-06-25 Fixed tux032 init after poweroff.
    Using avr-size in Makefile with script size.sh
    [tuner.c]
2014-07-03 Fix compile on LS020.
    [display.c, main.c]
2014-07-13 Fix bug with spectrum mirroring added in previous optimizing commits.
    [adc.c, tuner.h]
2014-07-14 Fixed wrong bit order in LM7001 control byte.
    [lm7001.h]
2014-07-17 Fix tunerSetFreq function for TEA5767.
    [tuner.c]
2014-08-15 Fix I2C read from RDA5807
2014-08-18 Don't switch on display backlight on power on.
2014-08-27 Fix unmuted volume on power on.
    [tda7439.c, tuner.h]
2014-09-03 Fix muting MUTE pin.
    [tda7439.c]
2014-09-03 Mute volume on poweron on TDA7313 and TDA7318.
2014-09-17 Fixed standby brightness at power on.
    [main.c]
2014-09-21 Labels instead of button number in learning mode.
2014-09-21 Added Belarusian eeprom. Fixed other eeproms.
    [font-ks0066-ru-08.c]
2014-09-22 Code refactoring, fix typos.
    [audio.c, audio.h, display.c, display.h, main.c]
2014-09-27 Rework ADC sync with display.
    [adc.c, adc.h, ks0108.c, ks0108.h, st7920.c, st7920.h]
2014-09-27 Switch compiler to O2 optimization level.
    It seems bug with defDisplayMode dissapear, true reason not found.
2014-10-03 Temperature control support.
2014-10-03 Fix bug when pull-up resistor is absent on 1-wire bus.
    [ds18x20.c, main.c]
2014-10-03 Exit from test and temp mode with button 1 long press.
2014-10-03 Replaced schematic images.
2014-10-08 Added temperature threshold icon. Small font changes.
2014-10-09 Fix mute behaviour when adjust volume.
    [main.c]
2014-11-02 Enable brown-out detection at 4V.
2014-12-06 Code refactoring and prepare for timer and alarm.
2014-12-06 Added standby timer.
2014-12-06 Fixed FM stations saving.
    [actions.c, actions.h, main.c]
2014-12-07 Fixed indicator level. Improvements for RDA5807.
    [display.c, tuner.c]
2014-12-07 Enable CKOPT fuse for stable 16MHz mode.
2014-12-07 Fix build without tuner.
    [actions.c, main.c]
2014-12-07 Changes in button 3 handling.
2014-12-07 Improved work with I2C.
2014-12-07 ADC correction values read from EEPROM.
    [adc.c, adc.h, eeprom.h]
2015-01-07 Fix weekdays order to satisfy DS1307 datasheet, where sunday = 1.
    [actions.c, display.c]
2015-01-18 Added CRC calculation when read temperature from DS18x20.
2015-01-18 Code restyling - switch to C-style comments.
2015-02-12 Audioprocessor and tuner can be powered off in standby mode.
2015-02-14 Better handling powering on/off.
2015-02-21 Reduce powerOn delay.
2015-02-23 ADC/FFT refactoring. 128 bytes of RAM released.
2015-02-25 Switch to virtual audioprocessor.
2015-02-25 Switch param refactoring.
2015-02-26 Fix change input from button 2.
    [main.c]
2015-02-26 Don't switch next input on first button press.
2015-02-27 Restore loudness on powerOn.
2015-02-27 Mute tuner on powerOn if not input0.
2015-02-27 Added option and remote button for spectrum fall speed.
2015-02-28 Fix various small bugs
    [display.c, eeprom.h, main.c]
2015-02-28 Encoder resolution can be set in eeprom.
    Resolution = pulses on turn.
    Negative values invert direction.
    [eeprom.h, input.c, main.c, pins.h]
2015-02-28 Remap POWER_ON, POWER_OFF, NEXT_INPUT commands
2015-03-01 Rename RC5 remote buttons to fit device.
2015-03-01 Added silence timer, which powers off device if there is no sound for 180 seconds.
2015-03-30 Fixed exit to default display.
    [actions.c]
2015-03-30 Timer code refactoring.
2015-04-15 Fix RDA5807 powerOn.
2015-04-15 PGA2310 basic frame.
2015-04-17 Set de-emphasis to 75us for TEA5767.
2015-06-19 Fix temperature calculation for DS18S20/DS1820.
    [ds18x20.c]
2015-08-10 Added basic ks0066 driver code.
2015-08-10 Interrupt for ADC work.
2015-08-12 Track current X posision in KS0066.
2015-08-12 Fix crash when regulating volume in alarm mode.
    [actions.c]
2015-08-12 Implemented temperature control for KS0066.
2015-08-12 Fix typo in code.
    [display.c]
2015-08-16 editor: Fix empty translations.
    [mainwindow.cpp]
2015-08-19 Added ks0066 schematic
2015-08-19 Fix ks0066 schematic.
2015-08-23 I2C refactoring.
2015-08-23 Fix temperature control.
2015-10-30 Fix poweron/poweroff sequence
2015-11-01 Added some useful files (pcbs, simulation project, etc)
    [pcbs.lay6, sim-m32-proteus7.dsn]
2015-11-16 Fix learn mode loop
    [display.c]
2015-11-22 Fix work with PGA2310
    [audioproc.c, mainwindow.cpp]
2015-11-24 Fix pga2310 sending data
    [pga2310.c]
2015-11-29 Fix prev input action
    [actions.c]
2015-11-29 Fix favourite stations indication
    [display.c, tuner.c, tuner.h]
2015-12-01 Show current input on poweron
2015-12-02 Fix temperature screen
2015-12-03 Fix button 3 action in timer mode
    [actions.c]
2015-12-03 Fix tuner init on non-zero input
    [actions.c, display.c, tuner.c]
2015-12-03 Fix timer screen
2015-12-03 Fix build for alphanumeric LCDs
    [display.c]
2015-12-06 ADC refactoring and speedup
2015-12-06 Fix spectrum hang on strong audio signal
    [display.c]
2015-12-09 Separate string for short weekdays
    [display.c, eeprom.h]
2015-12-11 Fix TDA731x setGain function
    [tda731x.c]
2015-12-16 Fix volume initialization on powerOn
    [audioproc.c]
2015-12-19 Fix remote volume button actions in edit modes
    [actions.c]
2015-12-28 Don't turn on fans on power on
2016-01-13 Fix toggle bit detection in RC5 protocol
    [remote.c]
2016-05-07 Handle encRes=0 as simple buttons
2016-05-27 Improve buttons/encoder
2016-05-27 Fix build with alphanumeric LCDs
    [display.c]
2016-05-30 Added schematic for ST7920
2016-05-31 Add support of LS020 display
    [sim-m32-proteus7-ls020.dsn]
2016-06-01 Addid LS020 display schematic
2016-06-02 Fix Samsung autorepeat bug
    [remote.c, remote.h]
2016-07-17 Fixed favourite station indication
    [display.c]
2016-07-17 Fix build non-128x64 displays
    [display.c]
2016-07-18 Updated pcbs
    [pcbs-m32.lay6, pcbs.lay6]
2016-07-18 Sync I2C code with m8 branch
2016-07-19 Small fix in editor
    [mainwindow.cpp]
2016-07-19 Display clear macro and fix adc mux
    [adc.c, display.c, display.h]
2016-07-20 Fix bug with FRONTREAR on TDA731X
    [audioproc.c]
2016-07-22 Optimizations and fixes in audioprocessors code
    [audio.c, pt232x.c, pt232x.h, tda731x.c, tda731x.h, tda7439.c, tda7439.h, tda7448.h]
2016-07-23 Small bugfixes in TDA7439 and RDA580X code
    [rda580x.c, tda7439.c]
2016-07-23 RDS can be switched off
2016-07-23 Fix bass control and very strange bug with fader in TDA731X
    [tda731x.c]
2016-07-23 Output RDS text with fixed font on GLCD
    [display.c, gdfb.c, gdfb.h]
2016-07-25 Fix visual glitches on RDS enable/disable
    [display.c]
2016-07-25 Auto reset RDS flag in ~3..4 seconds if no RDS signal
    [rda580x.c, rds.c]
2016-07-25 Fix input count for TEA6300
    [mainwindow.cpp]
2016-07-25 Remove blocking 500ms delay on power on
2016-08-02 Fixed surround/effect3d/tonedefeat switch bug
    [actions.c]
2016-08-02 Fix build on LS020 and KS0066
    [display.c]
2016-08-02 Fix audio param levels on power on
    [audio.c]
2016-08-02 Fix init timer
2016-08-02 Check remote control in main loop instead of interrupt
2016-08-03 Simple UART commands to emulate IR remote control
2016-08-03 Make UART insensitive to CR/LF/CRLF
2016-08-05 Fix middle/treble bug on PT232X
    [pt232x.c]
2016-08-05 Remote: autorepeat on volume buttons
2016-08-15 Fix bar mode on LS020
    [display.c]
2016-09-12 I2C SSD1306 128x64 OLED display support
2016-12-07 Fix FM scale on graphic 128x64 displays on high frequencies
    [display.c]
2016-12-24 Fix right channel drawing in stereo spectrum mode
    [adc.c, display.c]
2017-01-08 Fix handling _RDS definition
    [display.c]
2017-01-08 Software spi library used by pga2310/lm7001/lc72131
2017-04-19 Fix avr-gcc-5 compile error
    [fft.c]
2017-05-01 ADC code refactoring, intruduce auto DC offset correction
    [adc.c, adc.h]
2017-07-15 PCF8563 RTC support (via compiler switch in rtc.h)
2017-07-15 Add PCF8563 to proteus project
    [sim-m32-proteus7.dsn]
2017-09-24 Fix possible typo in LS020 driver
    [ls020.c]
2017-09-25 Modify LS020 m32 proteus project
    [sim-m32-proteus7-ls020.dsn]
2017-10-31 Fix Feb days calculation.
    [rtc.c]
2017-11-17 editor: Fix NEC sequence generation
    [irseq.cpp]
2017-11-19 Fix display some strings because of font change
    [display.c]
2018-01-05 Compile flags to disable temperature control
2018-01-05 Option to disable compilation of device control via UART feature
2018-01-07 Option to disable software SPI
2018-01-27 UART code refactoring
2018-01-27 ADC code refactoring
2018-01-28 Code style fixes after mass rework
    [audio.c, display.c, i2c.c, ks0066.c, ks0108.c, ls020.c, main.c, rda580x.c]
2018-02-08 Editor: remove ADC correction (not needed anymore)
    [mainwindow.cpp, mainwindow.h]
2018-02-24 Update binary proteus simulation files
    [sim-m32-proteus7-ls020.dsn, sim-m32-proteus7.dsn, sim-m328-proteus7.dsn]
2018-02-25 Remote: optimize Bluetooth device discovery and setup
2018-03-04 Makefile: add FUSEs for atmega328p
2018-03-16 Fix and improve i2c address detection
    [i2c.c, i2c.h, ks0066.c, rtc.c]
2018-03-23 Modify SI470x reset and add it's support to ATmega328 option
    [pins.h, si470x.c, uart.c]
2018-03-27 editor: fix build error
    [mainwindow.cpp]
2018-03-30 editor: fix some hide/show things for tuners
    [mainwindow.cpp]
2018-03-31 Tuner code refactoring and bug fixes
    [audio.c, audio.h, display.c, mainwindow.cpp, rda580x.c, rda580x.h, si470x.c, si470x.h]
2018-04-01 Fix storing stations found by seek
    [tuner.c]
2018-04-15 Make RDA5807 direct freq feature switchable
2018-04-16 Small adc/fft refactoring
2018-04-16 Small fix in software SPI
    [spisw.c]
2018-04-21 Fix build with RDS disabled
    [actions.c]
2018-04-29 Fix build error on atmega328p/168p
    [input.c]
2018-10-24 Init mode added
    EEPROM cell 0x35 values:
    0 or 1: remember last state when power loss
    Others: always start from standby mode
2018-12-03 Fix Si470x reset conflict with SPI_SW
    [main.c]
2018-12-03 Combine Si470x reset with display reset
    [ks0066.h, ks0108.c, ks0108.h, ls020.c, ls020.h, main.c, pins.h, si470x.c]
2018-12-04 Fix typo in m328 schematic
2018-12-08 Fix fake I2C start on hw reset
    [main.c]
2019-02-08 Fix cross icon on loudnes/3d/surround
    [display.c]
2019-03-28 Fix high level indication on KS0066
    [display.c]
2019-03-30 Fix FM control from front panel
    [actions.c, actions.h, display.c, display.h]
2019-09-18 Fix level calculation for right channel
    [display.c]
2019-12-07 Align ADC code with other branches
2019-12-18 Fix level meter on 128x64 displays
    [display.c]
2021-03-17 Fix spectrum on ATmega328p
    [adc.h]
2021-08-13 Add OLED wiring to readme
2023-07-25 editor: Fix Wimplicit-fallthrough warnings
    [mainwindow.cpp]
